SomaticVR/Eros-Hardware/3DModels/FXL6408UMX.stp

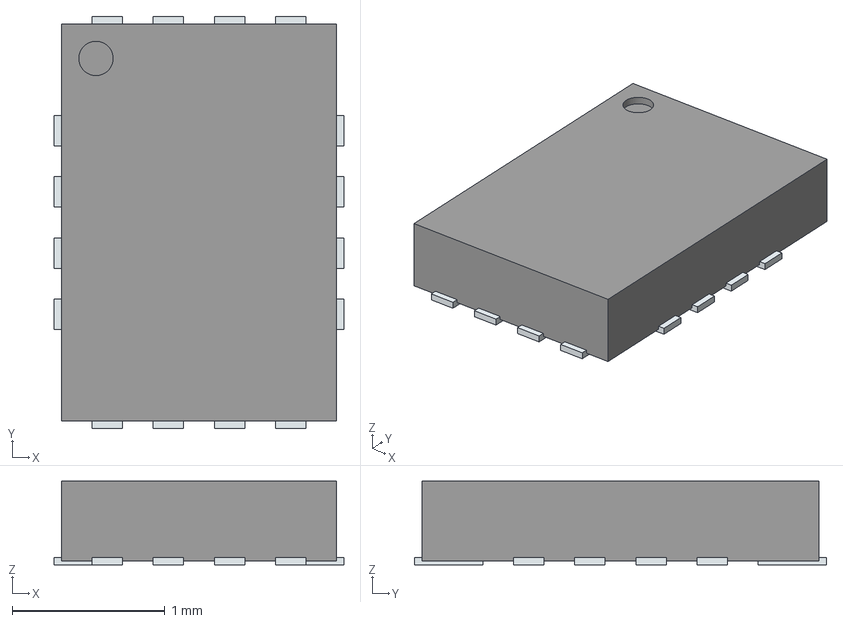
[picture p1: CAD file, 2025-02-08]
3DModels/FXL6408UMX.stp
1.90 x 2.70 x 0.55 mm
PinsArrayLR
PinsArrayTB
