SomaticVR/Eros-Hardware/3DModels/FUSB302BUCX.stp

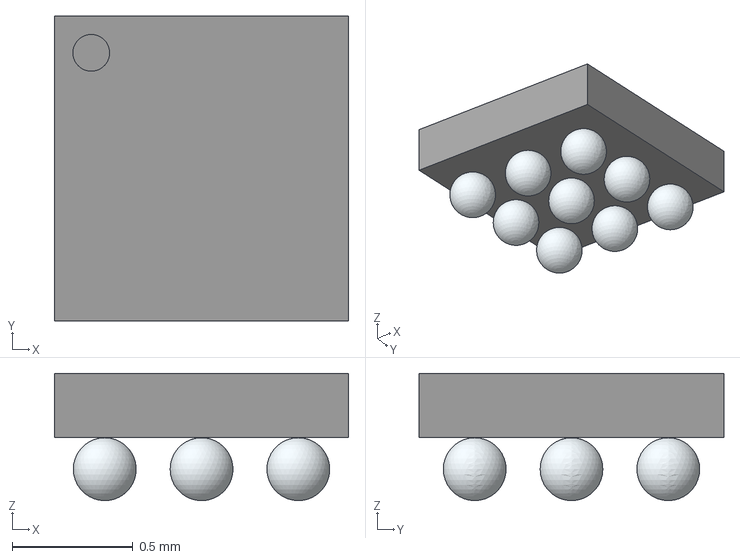
[picture p2: CAD file, 2025-02-08]
3DModels/FUSB302BUCX.stp
1.22 x 1.26 x 0.526 mm
