SomaticVR/Eros-Hardware/3DModels/CAY10-xxxJ4.stp

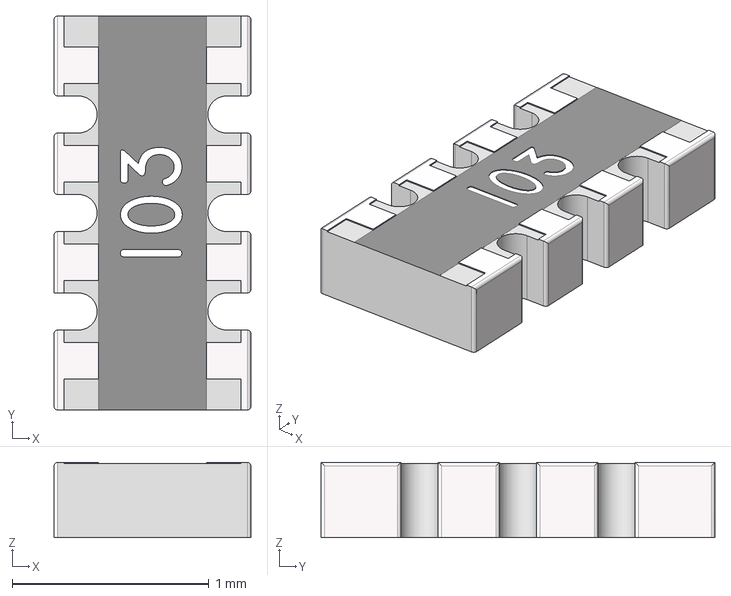
[picture p3: CAD file, 2023-10-31]
3DModels/CAY10-xxxJ4.stp
1.00 x 2.00 x 0.381 mm
