SomaticVR/Eros-Hardware/3DModels/USB4110-GF-A.stp

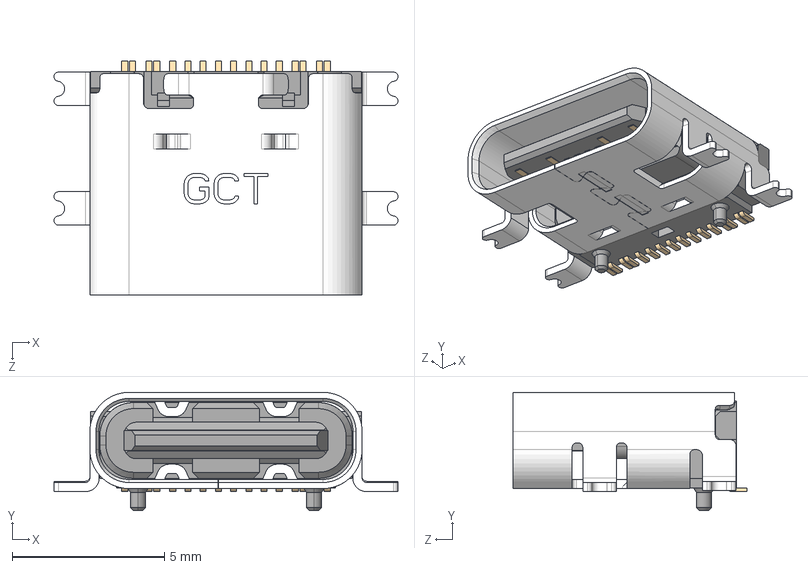
[picture p4: CAD file, 2023-10-31]
3DModels/USB4110-GF-A.stp
11.3 x 3.89 x 7.70 mm
