SomaticVR/Eros-Hardware/3DModels/EVQ-P7A01P.stp

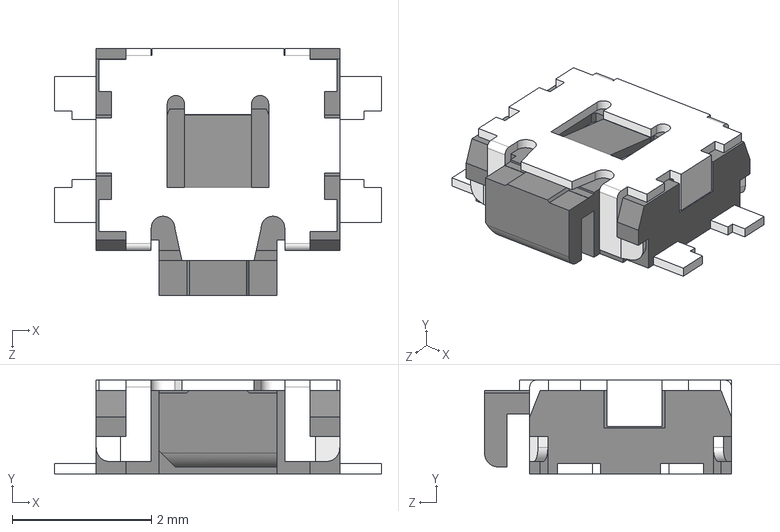
[picture p5: CAD file, 2023-10-31]
3DModels/EVQ-P7A01P.stp
4.70 x 1.35 x 3.55 mm
