SomaticVR/Eros-Hardware/3DModels/PESD5V2S2UT,215.stp

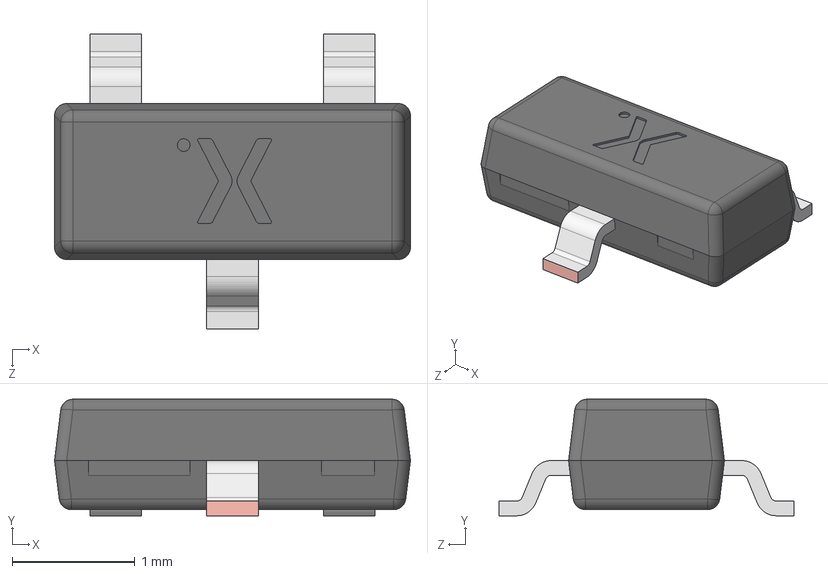
[picture p6: CAD file, 2023-10-31]
3DModels/PESD5V2S2UT,215.stp
2.90 x 0.95 x 2.40 mm
SOT23 lower body
SOT23 Lead x 3
SOT23 Upper body
