SomaticVR/Eros-Hardware/3DModels/S2B-PH-SM4-TB_LF__SN_ v2.step

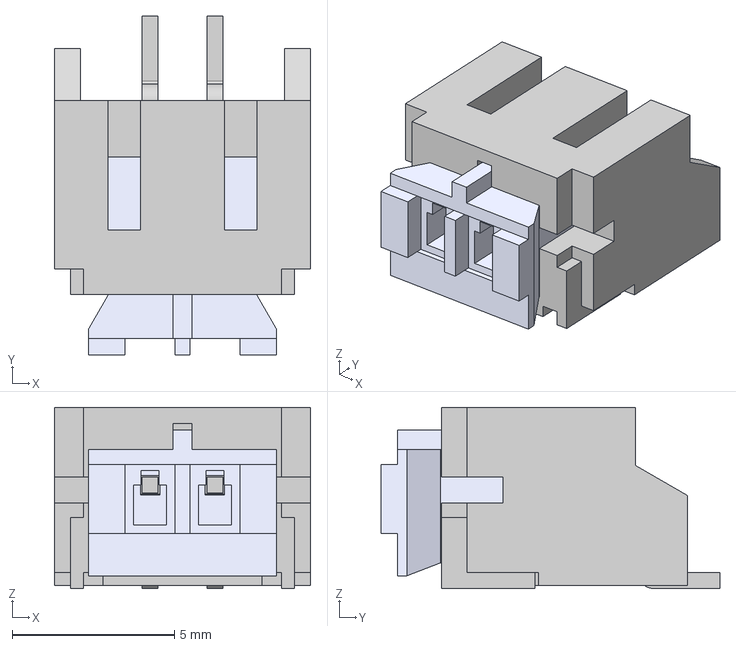
[picture p7: CAD file, 2023-10-31]
3DModels/S2B-PH-SM4-TB_LF__SN_ v2.step
7.90 x 10.5 x 5.60 mm
