SomaticVR/Eros-Hardware/3DModels/B2B-PH-SM4-TB_LF__SN_.stp

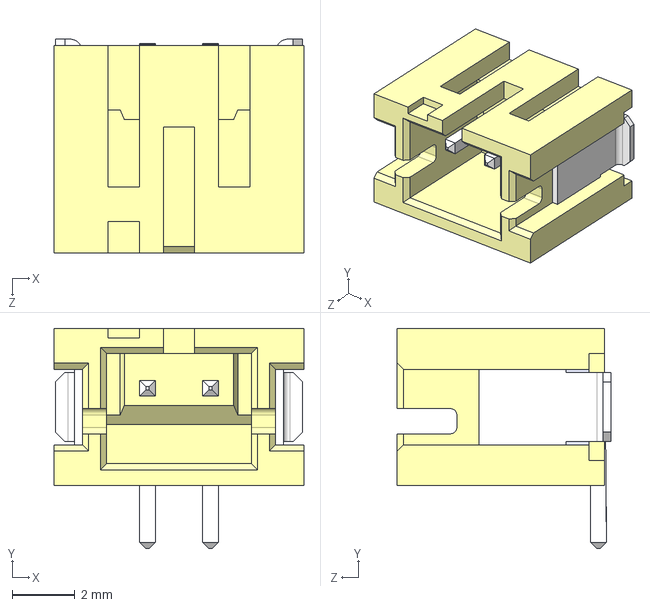
[picture p8: CAD file, 2023-10-31]
3DModels/B2B-PH-SM4-TB_LF__SN_.stp
7.95 x 7.00 x 6.80 mm
