SomaticVR/Eros-Hardware/3DModels/ESP32-C3-MINI-1-N4.step

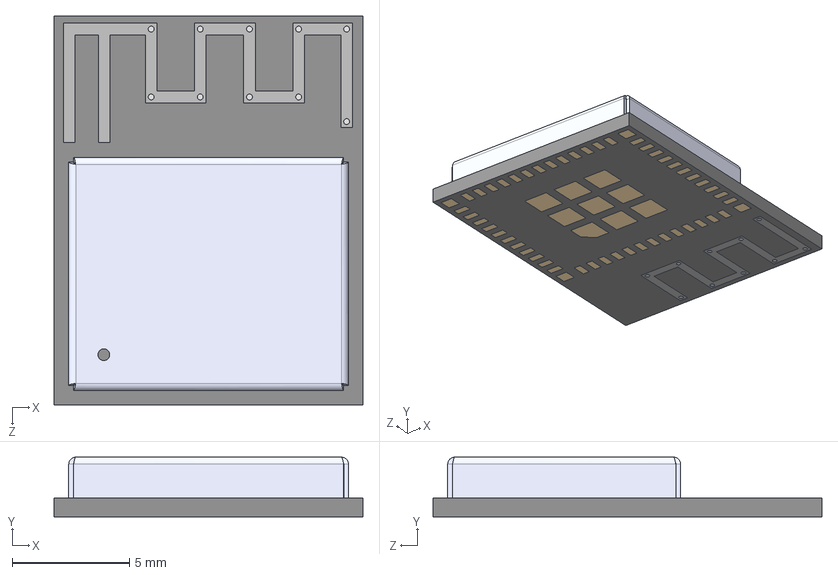
[picture p9: CAD file, 2023-10-31]
3DModels/ESP32-C3-MINI-1-N4.step
13.2 x 2.55 x 16.6 mm
