SomaticVR/Eros-Hardware/3DModels/4Z08V1345T7D2.stp

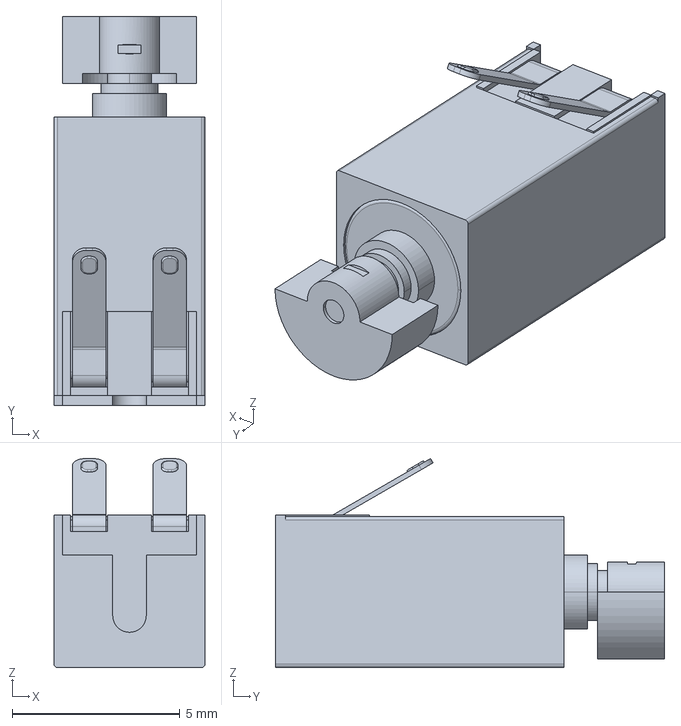
[picture p10: CAD file, 2023-10-31]
3DModels/4Z08V1345T7D2.stp
4.50 x 11.6 x 6.23 mm
