SomaticVR/Eros-Hardware/3DModels/ECMF02-4CMX8.stp

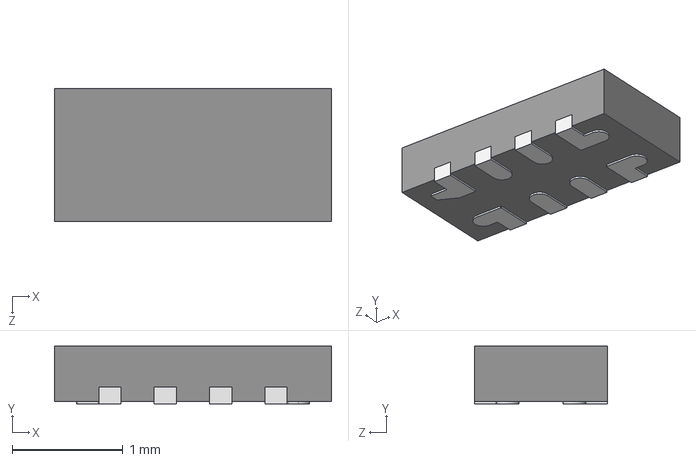
[picture p11: CAD file, 2023-10-31]
3DModels/ECMF02-4CMX8.stp
2.50 x 0.52 x 1.20 mm
