SomaticVR/Eros-Hardware/3DModels/Strike Plate v1.step

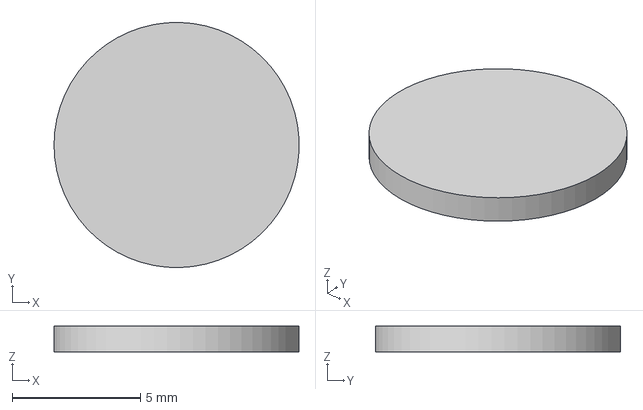
[picture p12: CAD file, 2023-06-08]
3DModels/Strike Plate v1.step
9.54 x 9.55 x 1.00 mm
