SomaticVR/Eros-Hardware/3DModels/BAS40VYX.stp

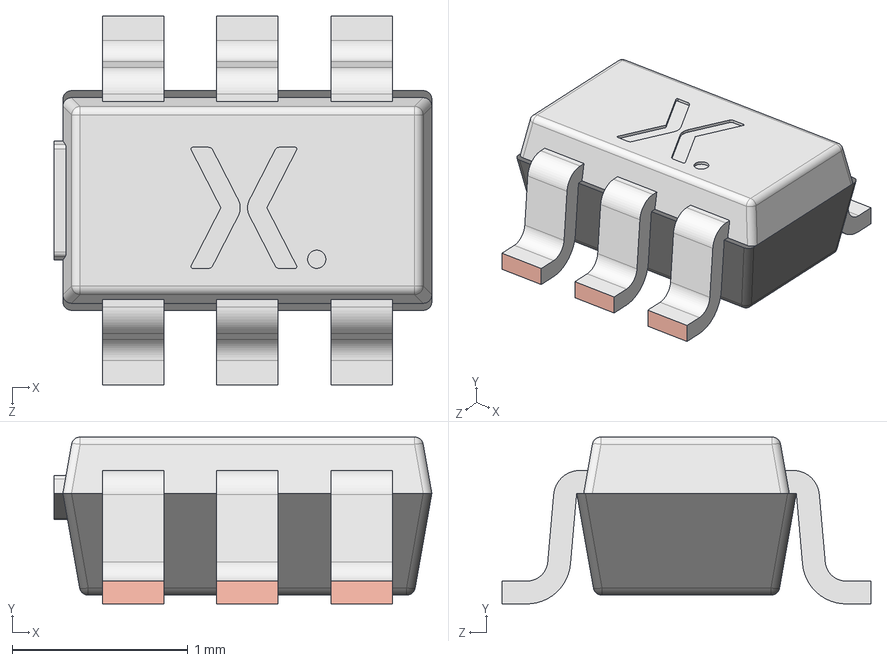
[picture p13: CAD file, 2023-06-04]
3DModels/BAS40VYX.stp
2.15 x 0.95 x 2.10 mm
SOT353 Lower body
SOT353 Lead x 6
SOT353 Upper body
