SomaticVR/Eros-Hardware/3DModels/keystone-PN24881.STEP

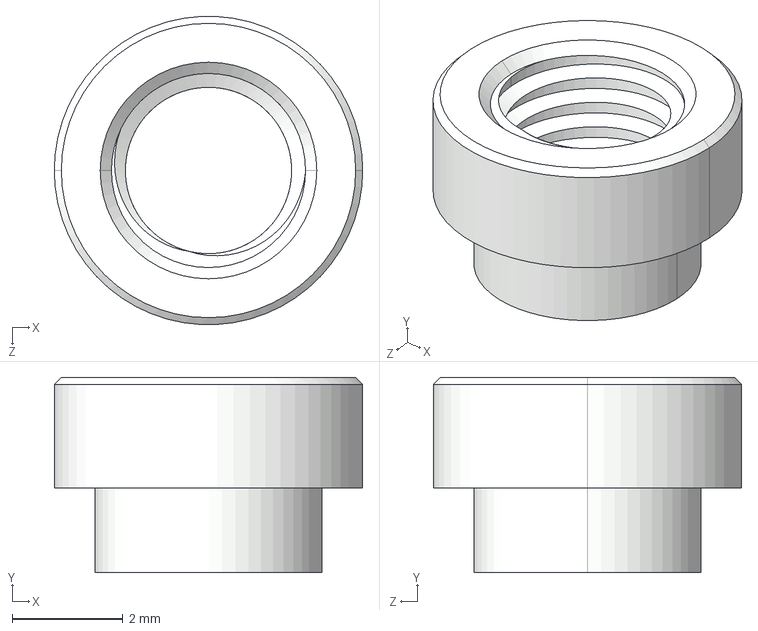
[picture p14: CAD file, 2023-06-04]
3DModels/keystone-PN24881.STEP
5.56 x 3.52 x 5.55 mm
