SomaticVR/Eros-Hardware/3DModels/JST - PH - SMD (R) - 2Pin - 2.00mm.stp

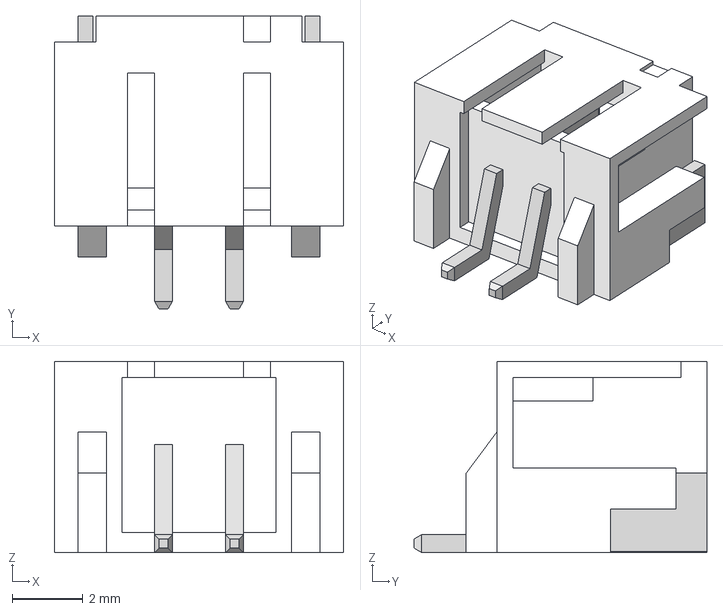
[picture p15: CAD file, 2023-06-04]
3DModels/JST - PH - SMD (R) - 2Pin - 2.00mm.stp
8.15 x 8.26 x 5.38 mm
