SomaticVR/Eros-Hardware/3DModels/SS34FA.stp

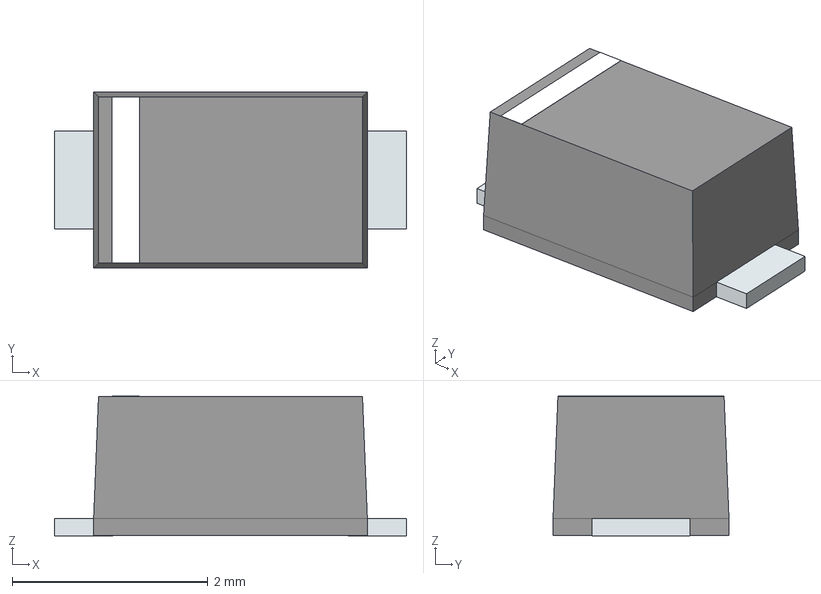
[picture p16: CAD file, 2023-06-04]
3DModels/SS34FA.stp
3.60 x 1.80 x 1.43 mm
PinKIdent
PinK
PinA
