SomaticVR/Eros-Hardware/3DModels/DMP2240UDM-7.stp

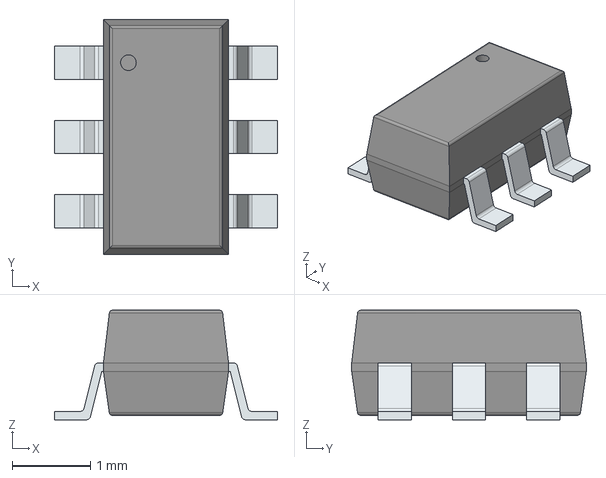
[picture p17: CAD file, 2023-06-04]
3DModels/DMP2240UDM-7.stp
2.85 x 3.00 x 1.40 mm
PinsArrayLR
