SomaticVR/Eros-Hardware/3DModels/APDA3020.STEP

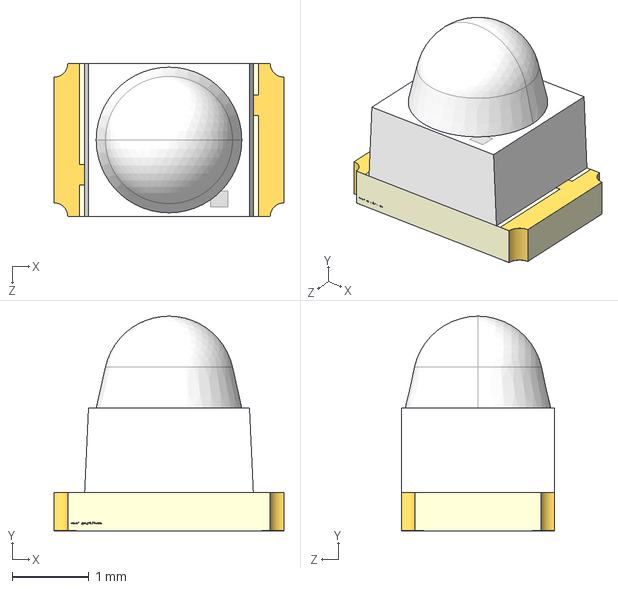
[picture p18: CAD file, 2023-06-04]
3DModels/APDA3020.STEP
3.00 x 2.80 x 2.00 mm
