SomaticVR/Eros-Hardware/3DModels/S2B-PH-SM4-TB_LF__SN_.stp

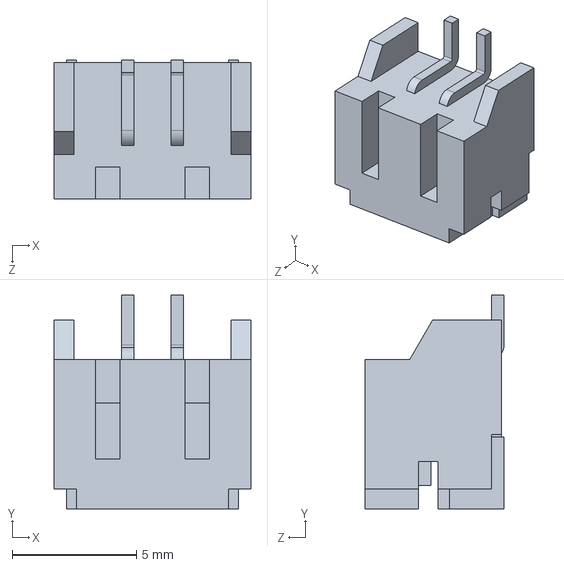
[picture p19: CAD file, 2023-06-04]
3DModels/S2B-PH-SM4-TB_LF__SN_.stp
7.90 x 8.60 x 5.60 mm
