SomaticVR/Eros-Hardware/3DModels/EVQ-9P701P.stp

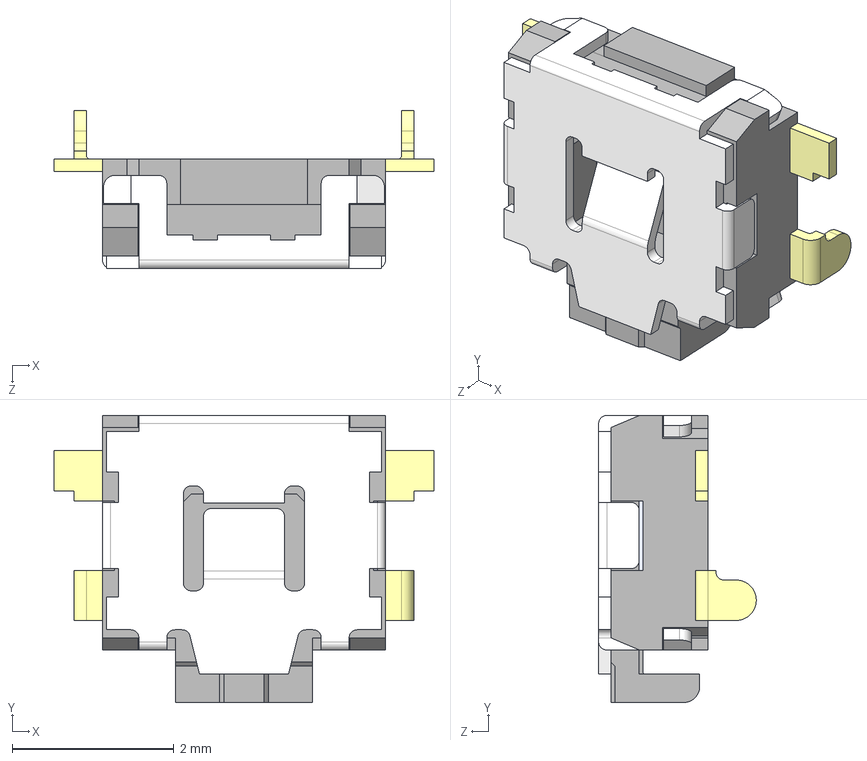
[picture p20: CAD file, 2023-06-04]
3DModels/EVQ-9P701P.stp
4.70 x 3.55 x 1.95 mm
