SomaticVR/Eros-Hardware/3DModels/JST - PH - SMD (R) - 8Pin - 2.00mm.stp

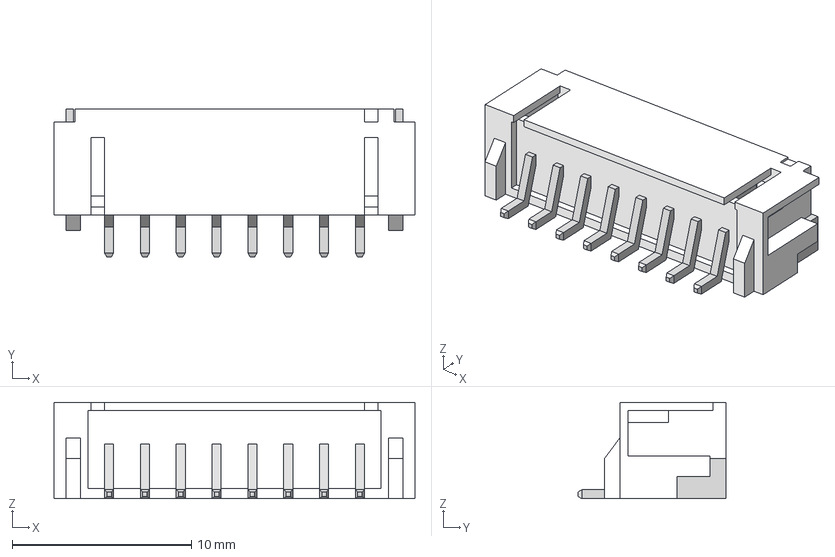
[picture p21: CAD file, 2023-06-04]
3DModels/JST - PH - SMD (R) - 8Pin - 2.00mm.stp
20.1 x 8.26 x 5.38 mm
