SomaticVR/Eros-Hardware/3DModels/ESP32-C3-WROOM-02-N4--3DModel-STEP-269445.STEP

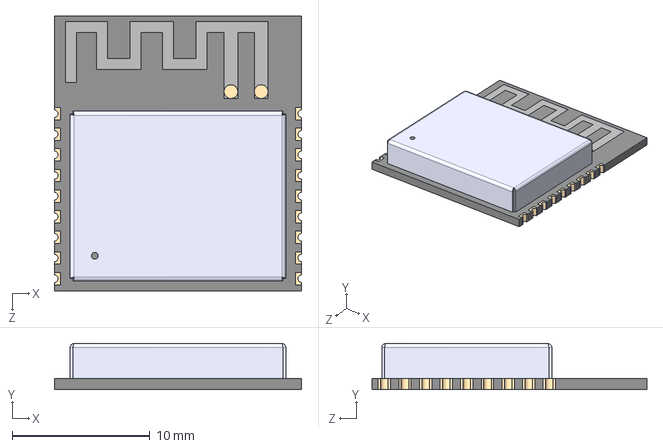
[picture p22: CAD file, 2023-04-05]
3DModels/ESP32-C3-WROOM-02-N4--3DModel-STEP-269445.STEP
18.0 x 3.35 x 20.0 mm
