SomaticVR/Eros-Hardware/(list of files, cad)

Other CAD files:
3DModels/S2B-PH-SM4-TB_LF__SN_ v1 with connector.step
3DModels/2171790001.stp
3DModels/AP62250Z6-7.stp
3DModels/BQ24074RGTRG4.stp
3DModels/BQ24196RGER.stp
3DModels/BQ25185DLHR.stp
3DModels/DFE252012F-1R0M=P2.stp
3DModels/DFE322512F-2R2M=P2.stp
3DModels/MCP73834-FCI_MF.stp
3DModels/TLV61070ADBVR.stp
3DModels/TPS563206DRLR.stp
