SomaticVR/Eros-Hardware/Eros Tracker.kicad_pcb

## KiCad design Eros Tracker.kicad_pcb (2025-02-08)

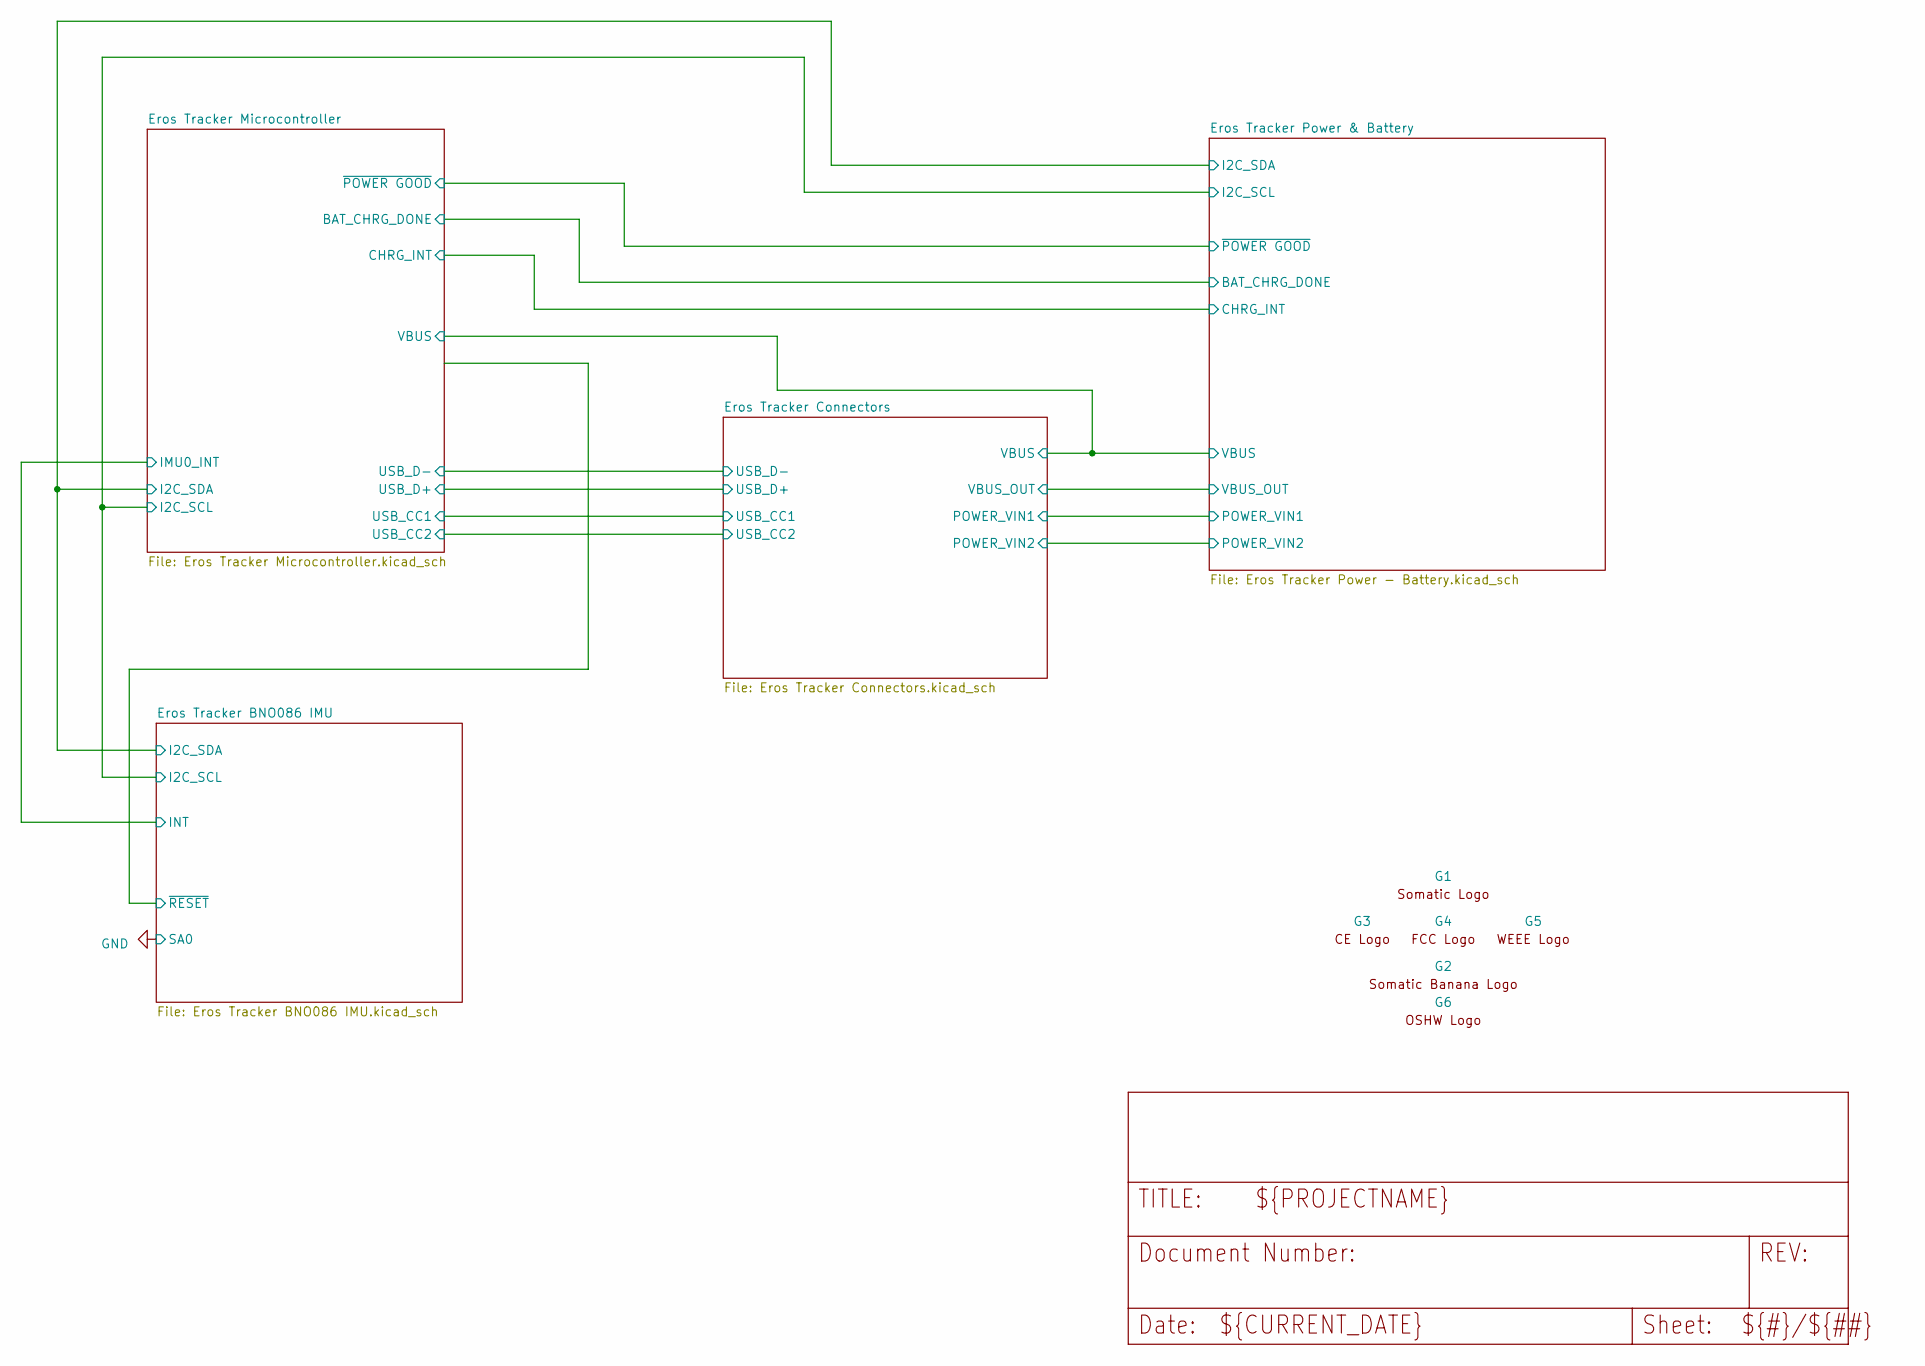
[picture p23: schematic Eros Tracker.kicad_sch]

Parts:
G1: SomaticLogo
G2: SomaticBananaLogo
G3: CE-Logo_7.0x5.0mm_SilkScreen
G4: FCC-Logo_6.2x5.0mm_SilkScreen
G5: WEEE-Logo_4.2x6mm_SilkScreen
G6: OSHW-Logo2_7.3x6mm_SilkScreen

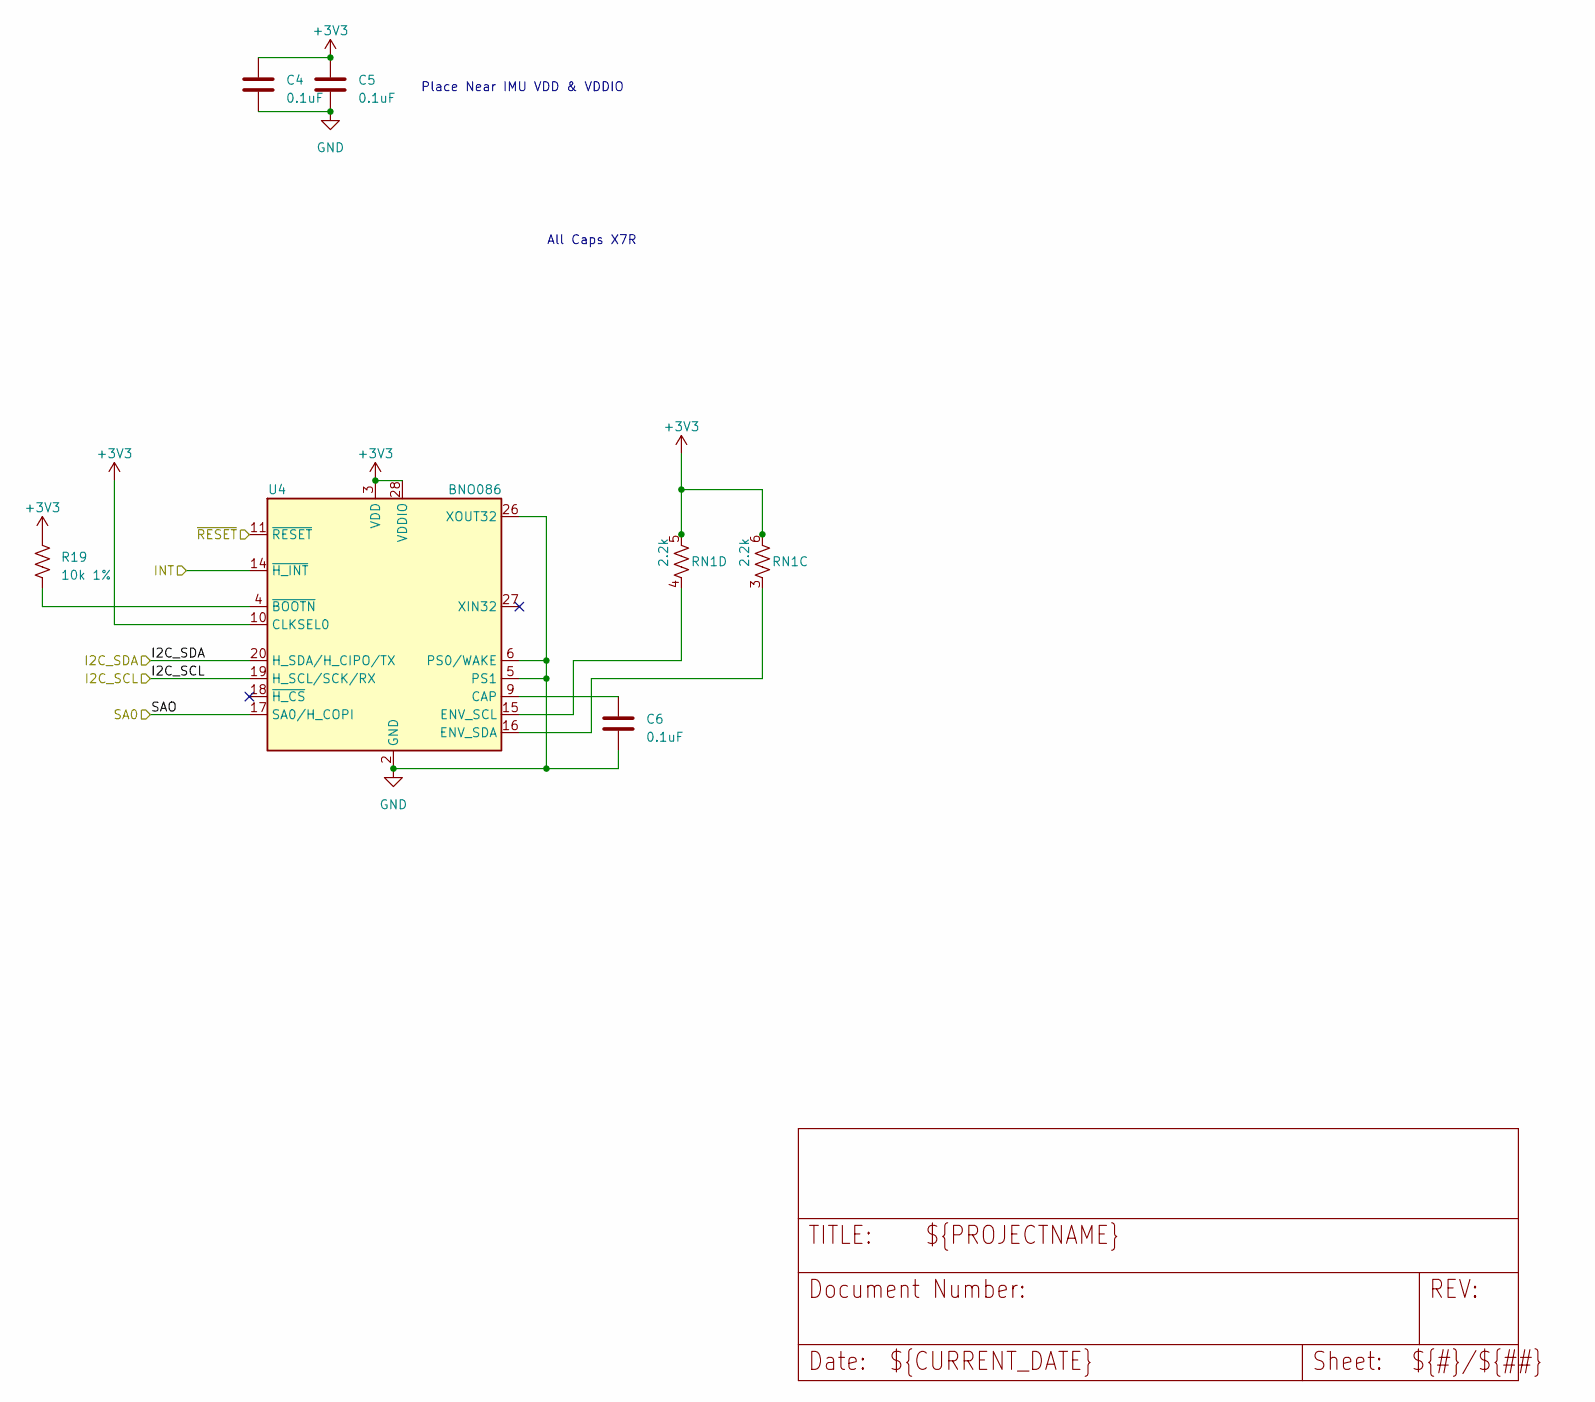
[picture p24: schematic Eros Tracker BNO086 IMU.kicad_sch]

Parts:
C4, C5, C6: 0.1uF; C_0402_1005Metric; Manufacturer_Part_Number CL05B104KA5NNNC; Mouser Part Number 187-CL05B104KA5NNNC
R19: 10k 1%; R_0402_1005Metric; Manufacturer_Part_Number RT0402FRE0710KL; Mouser Part Number 603-RT0402FRE0710KL
RN1: 2.2k; CAY10-xxxJ4; Manufacturer_Part_Number CAY10-222J4LF; Mouser Part Number 652-CAY10-222J4LF
U4: BNO086; LGA-28_5.2x3.8mm_P0.5mm; Manufacturer_Part_Number BNO086; DigiKey Part Number 1888-BNO086CT-ND

Connections:
+3V3: C4.1, C5.1, R19.1, RN1.5, RN1.6, U4.3 (VDD), U4.10 (CLKSEL0), U4.28 (VDDIO); also elsewhere on the board
/Eros Tracker BNO086 IMU/I2C_SCL: U4.19 (H_SCL/SCK/RX); also elsewhere on the board
/Eros Tracker BNO086 IMU/I2C_SDA: U4.20 (H_SDA/H_CIPO/TX); also elsewhere on the board
/Eros Tracker BNO086 IMU/INT: U4.14 (~H_INT); also elsewhere on the board
/Eros Tracker BNO086 IMU/~RESET: U4.11 (~RESET)
GND: C4.2, C5.2, C6.2, U4.2 (GND), U4.5 (PS1), U4.6 (PS0/WAKE), U4.17 (SA0/H_COPI), U4.25 (GNDIO), U4.26 (XOUT32); also elsewhere on the board
unnamed: C6.1, U4.9 (CAP)
unnamed: RN1.4, U4.15 (ENV_SCL)
unnamed: RN1.3, U4.16 (ENV_SDA)
unnamed: R19.2, U4.4 (~BOOTN)

Notes on the sheet:
Place Near IMU VDD & VDDIO
All Caps X7R

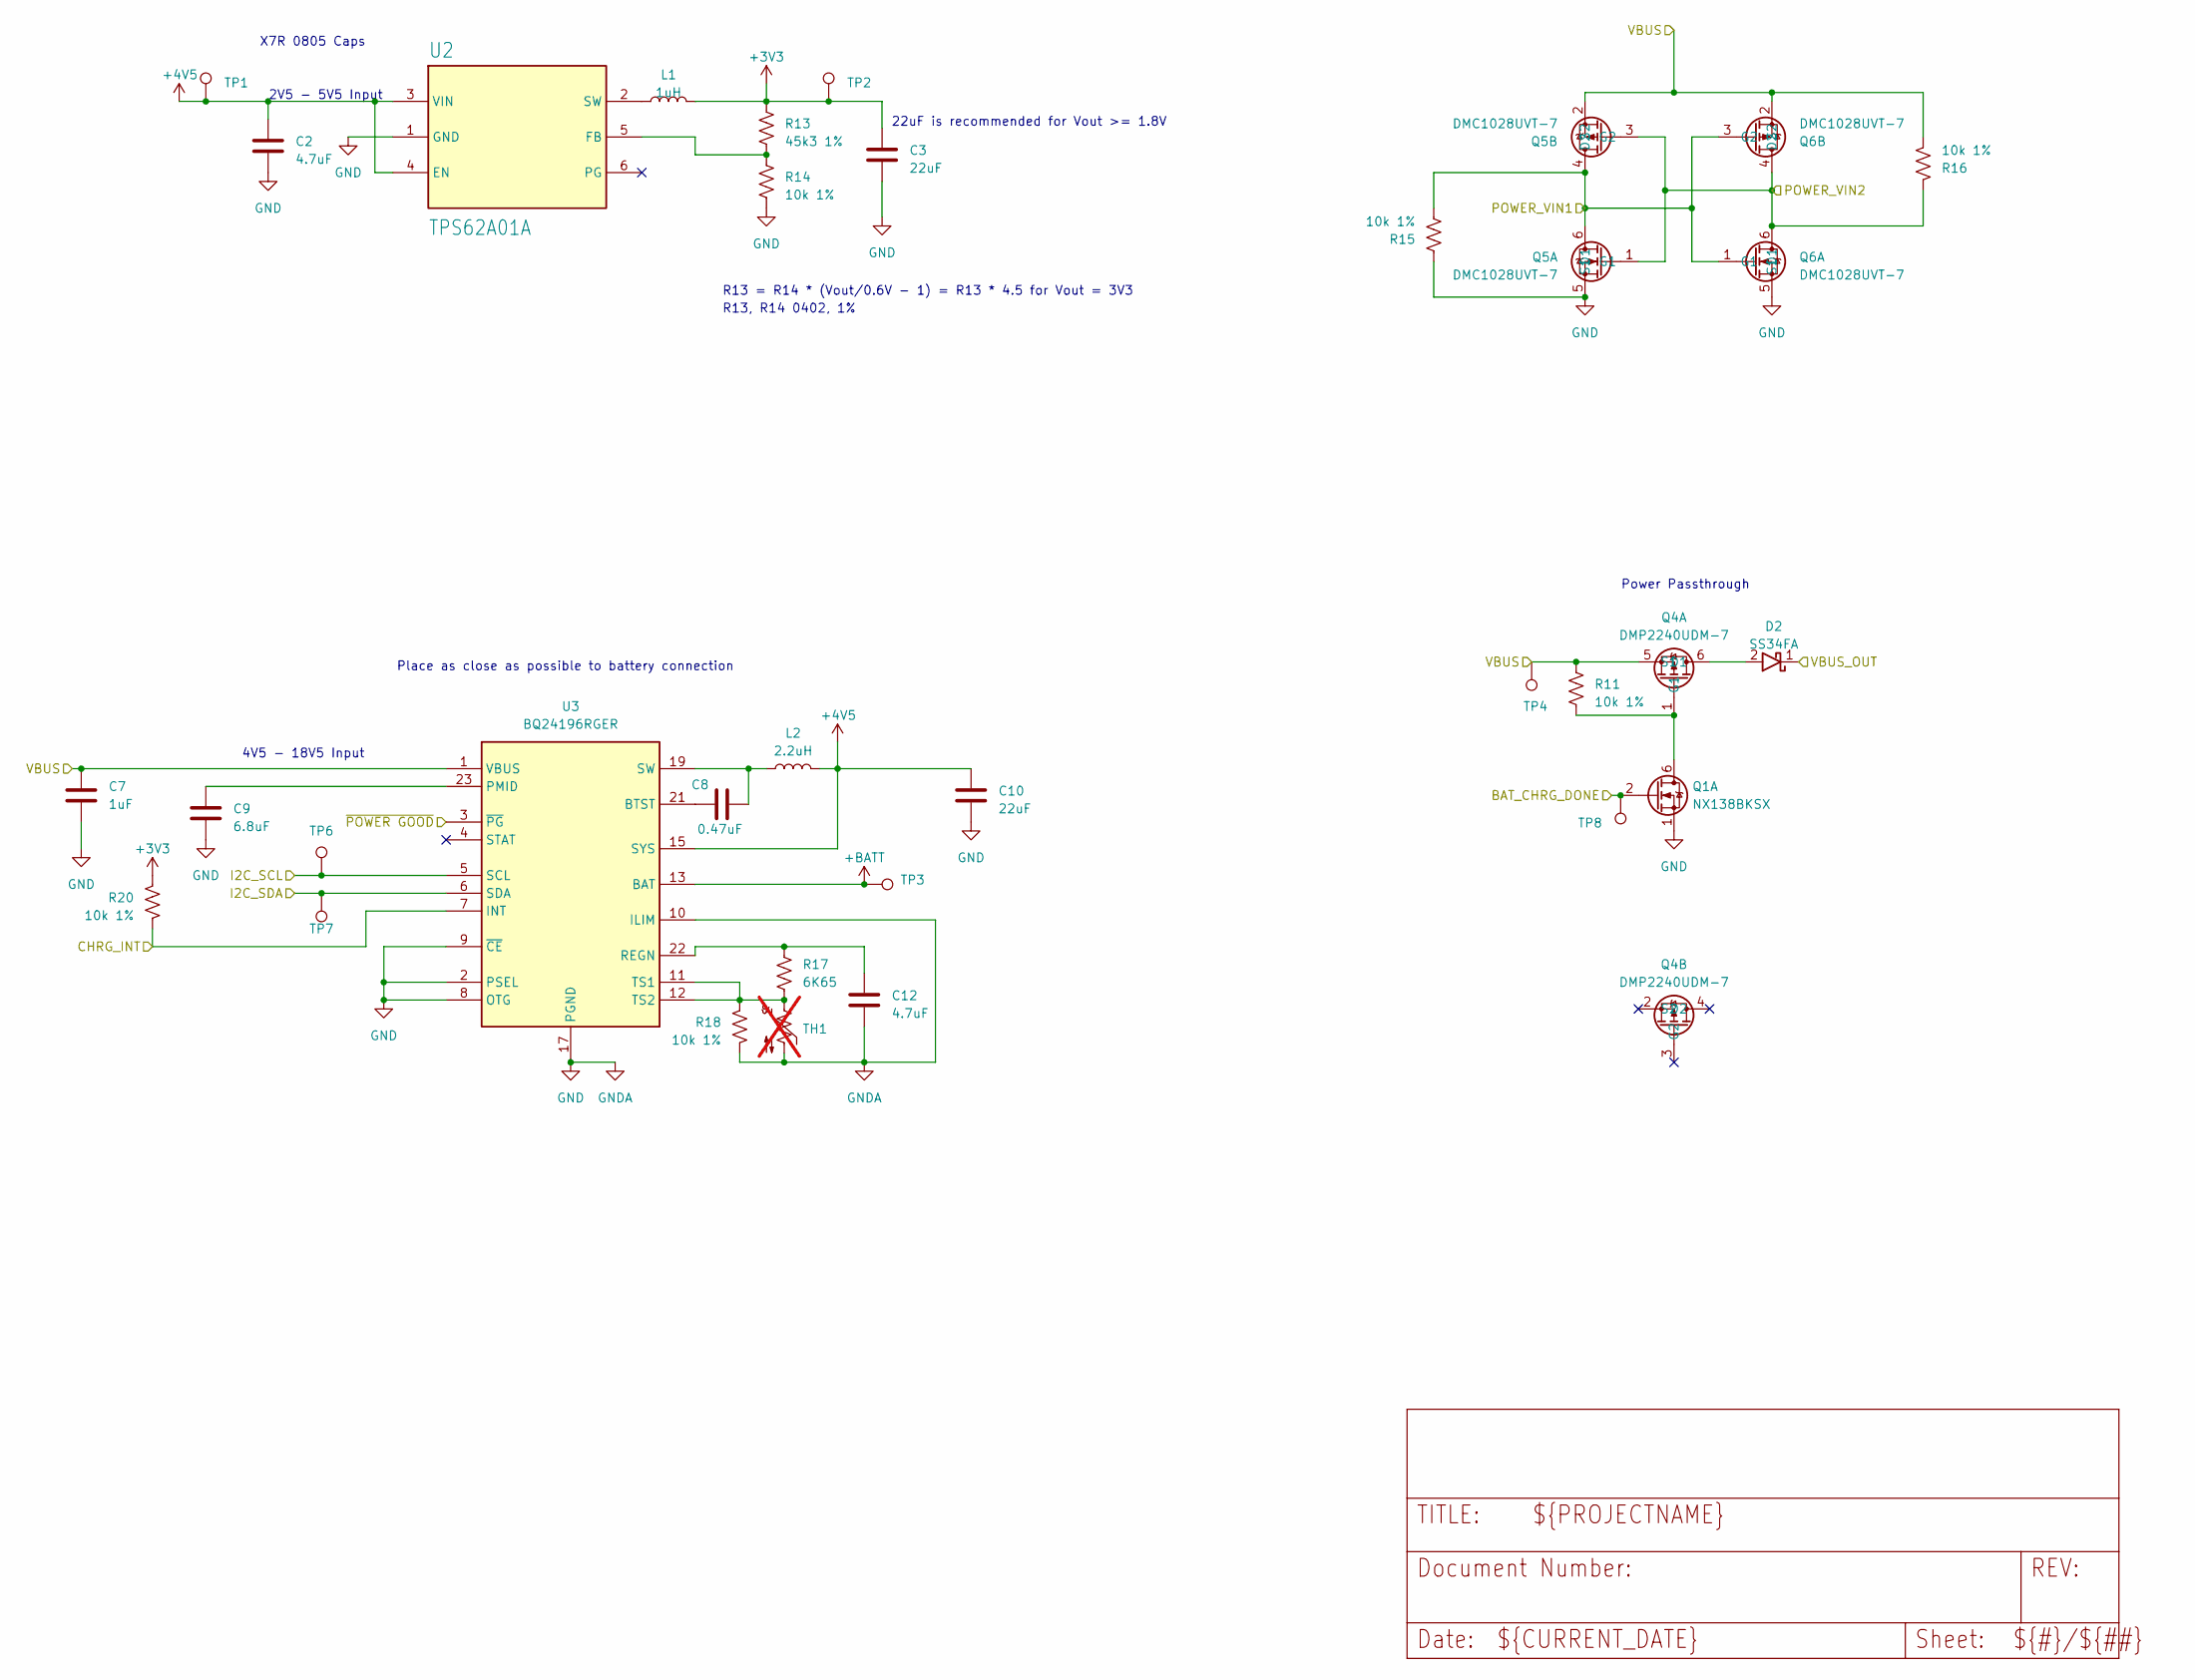
[picture p25: schematic Eros Tracker Power - Battery.kicad_sch]

Parts:
C2, C12: 4.7uF; C_0603_1608Metric; Manufacturer_Part_Number GRM188Z71C475KE21D; Mouser Part Number 81-GRM188Z71C475KE1D
C3, C10: 22uF; C_0805_2012Metric; Manufacturer_Part_Number GRM21BZ71A226ME15L; Mouser Part Number 81-GRM21BZ71A226ME5L
C7: 1uF; C_0603_1608Metric; Manufacturer_Part_Number MLASU168AB7105KTNA01; Mouser Part Number 963-MLASU168AB7105KT
C8: 0.47uF; C_0402_1005Metric; Manufacturer_Part_Number CC0402KRX7R6BB474; Mouser Part Number 603-CC0402KR6BB474
C9: 6.8uF; C_1210_3225Metric; Manufacturer_Part_Number C3225X7R1E685K250AB; Mouser Part Number 810-C3225X7R1E685K11
D2: SS34FA; SODFL3618X143N; Mouser Part Number 512-SS34FA
L1: 1uH; DFE2HCAH1R0MJ0L; Manufacturer_Part_Number DFE252012F-1R0M=P2; Mouser Part Number 81-DFE252012F-1R0MP2
L2: 2.2uH; 1277ASH100MP2; Manufacturer_Part_Number DFE322512F-2R2M=P2; Mouser Part Number 81-DFE322512F-2R2MP2
Q1: NX138BKSX; SOT65P210X110-6N; Mouser Part Number 771-NX138BKSX
Q4: DMP2240UDM-7; SOT95P285X140-6N; Mouser Part Number 621-DMP2240UDM-7
Q5, Q6: DMC1028UVT-7; SOT95P285X140-6N; Mouser Part Number 621-DMC1028UVT-7
R11, R14, R15, R16, R18, R20: 10k 1%; R_0402_1005Metric; Manufacturer_Part_Number RT0402FRE0710KL; Mouser Part Number 603-RT0402FRE0710KL
R13: 45k3 1%; R_0402_1005Metric; Manufacturer_Part_Number RR0510P-4532-D; Mouser Part Number 754-RR0510P-4532D
R17: 6K65; R_0402_1005Metric; Manufacturer_Part_Number RT0402DRE076K65L; Mouser Part Number 603-RT0402DRE076K65L
TH1: 10k; R_0402_1005Metric; Manufacturer_Part_Number NTCG103UH103HT1; Mouser Part Number 810-NTCG103UH103HT1; not fitted
TP1, TP2, TP3, TP4, TP6, TP7, TP8: TestPoint; TestPoint_Pad_D1.0mm
U2: TPS62A01A; TPS62A0xA-SOT-563; Manufacturer_Part_Number TPS62A01ADRLR; Mouser Part Number 595-TPS62A01ADRLR
U3: BQ24196RGER; QFN50P400X400X100-25N-D; Mouser Part Number 595-BQ24196RGER

Connections:
+3V3: C3.1, L1.2, R13.1, R20.1, TP2.1; also elsewhere on the board
+4V5: C2.1, C10.1, L2.2, TP1.1, U2.3 (VIN), U2.4 (EN), U3.15 (SYS), U3.16 (SYS_2); also elsewhere on the board
+BATT: TP3.1, U3.13 (BAT), U3.14 (BAT_2); also elsewhere on the board
/Eros Tracker BNO086 IMU/I2C_SCL: TP6.1, U3.5 (SCL); also elsewhere on the board
/Eros Tracker BNO086 IMU/I2C_SDA: TP7.1, U3.6 (SDA); also elsewhere on the board
/Eros Tracker Connectors/POWER_VIN1: Q5.4 (D2), Q5.6 (D1), Q6.1 (G1), Q6.3 (G2), R15.2; also elsewhere on the board
/Eros Tracker Connectors/POWER_VIN2: Q5.1 (G1), Q5.3 (G2), Q6.4 (D2), Q6.6 (D1), R16.1; also elsewhere on the board
/Eros Tracker Connectors/VBUS: C7.1, Q4.5 (S1), Q5.2 (S2), Q6.2 (S2), R11.1, R16.2, TP4.1, U3.1 (VBUS), U3.24 (VBUS_2); also elsewhere on the board
/Eros Tracker Connectors/VBUS_OUT: D2.1 (K); also elsewhere on the board
/Eros Tracker Microcontroller/BAT_CHRG_DONE: Q1.2 (G1), TP8.1; also elsewhere on the board
/Eros Tracker Microcontroller/CHRG_INT: R20.2, U3.7 (INT); also elsewhere on the board
/Eros Tracker Microcontroller/~POWER GOOD: U3.3 (~PG); also elsewhere on the board
GND: C2.2, C3.2, C7.2, C9.2, C10.2, C12.2, Q1.1 (S1), Q5.5 (S1), Q6.5 (S1), R14.2, R15.1, R18.2, TH1.2, U2.1 (GND), U3.2 (PSEL), U3.8 (OTG), U3.9 (~CE), U3.10 (ILIM), U3.17 (PGND), U3.18 (PGND_2), U3.25 (EP); also elsewhere on the board
unnamed: D2.2 (A), Q4.6 (D1)
unnamed: Q1.6 (D1), Q4.1 (G1), R11.2
unnamed: R13.2, R14.1, U2.5 (FB)
unnamed: L1.1, U2.2 (SW)
unnamed: C8.1, U3.21 (BTST)
unnamed: C9.1, U3.23 (PMID)
unnamed: C12.1, R17.1, U3.22 (REGN)
unnamed: C8.2, L2.1, U3.19 (SW), U3.20 (SW_2)
unnamed: R17.2, R18.1, TH1.1, U3.11 (TS1), U3.12 (TS2)

Notes on the sheet:
22uF is recommended for Vout >= 1.8V
R13 = R14 * (Vout/0.6V - 1) = R13 * 4.5 for Vout = 3V3
Power Passthrough
2V5 - 5V5 Input
4V5 - 18V5 Input
X7R 0805 Caps
Place as close as possible to battery connection
R13, R14 0402, 1%

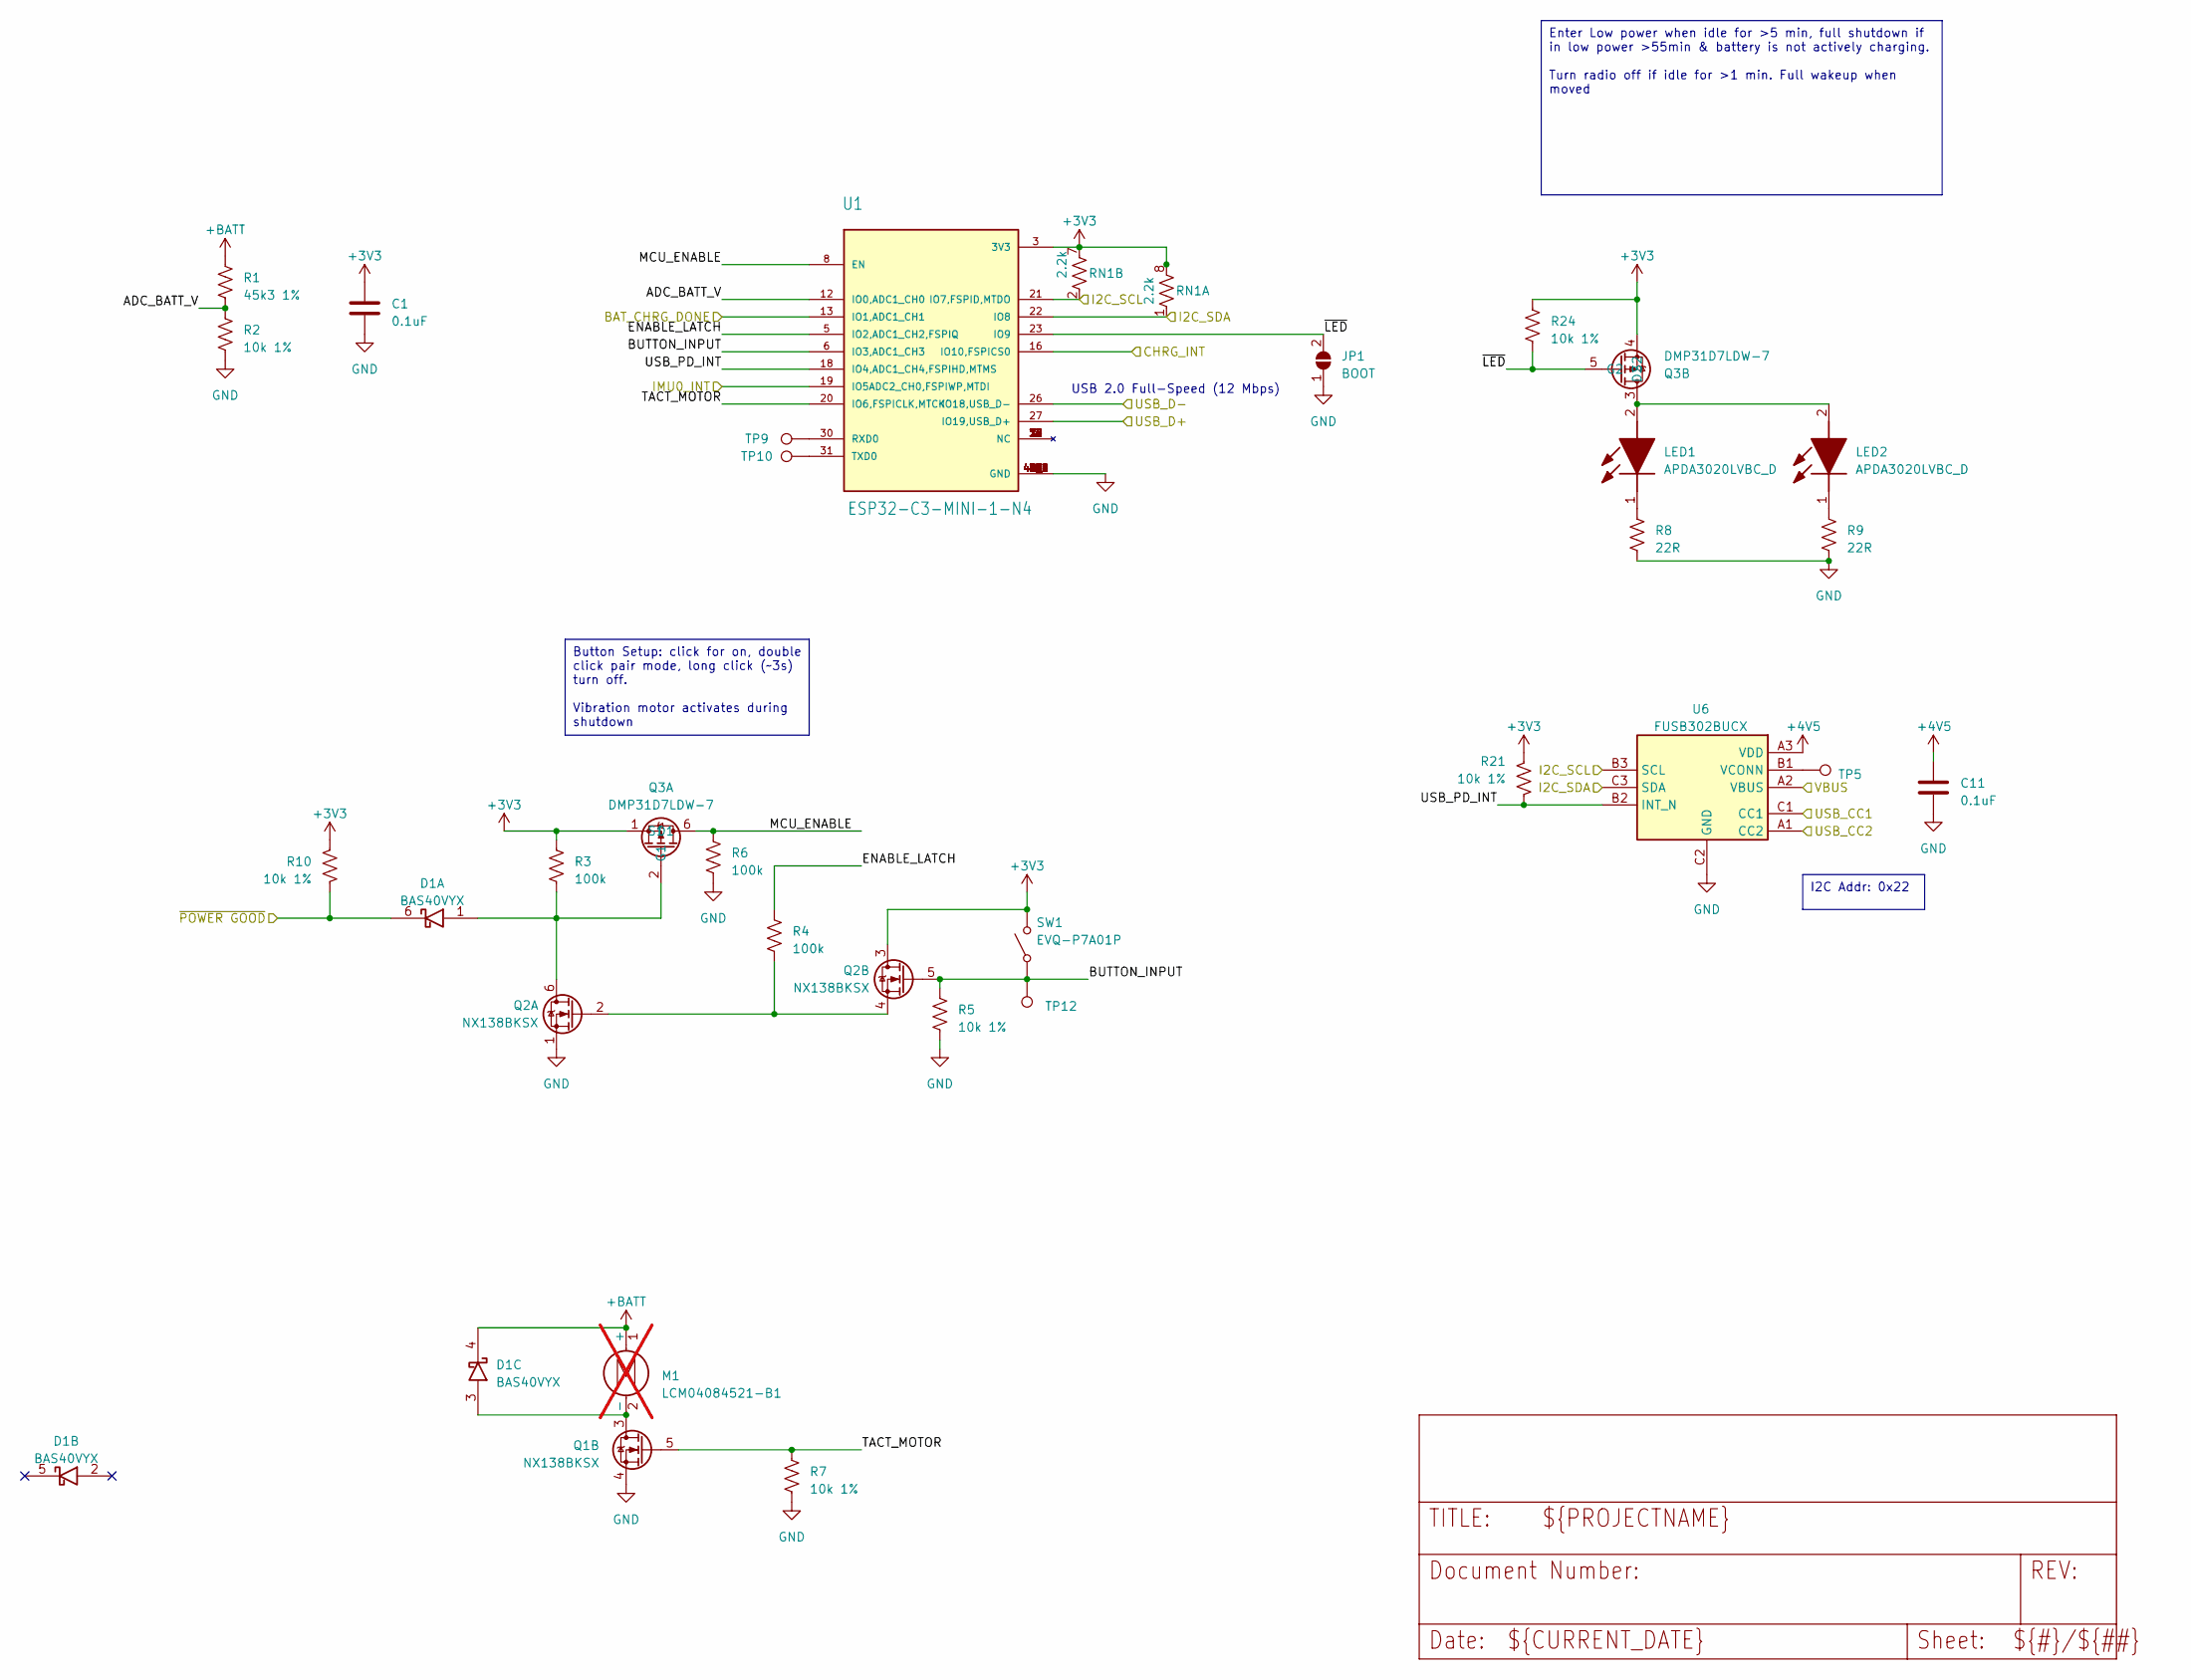
[picture p26: schematic Eros Tracker Microcontroller.kicad_sch]

Parts:
C1, C11: 0.1uF; C_0402_1005Metric; Manufacturer_Part_Number CL05B104KA5NNNC; Mouser Part Number 187-CL05B104KA5NNNC
D1: BAS40VYX; SOT65P210X110-6N; Manufacturer_Part_Number BAS40VYX
JP1: BOOT; SolderJumper-2_P1.3mm_Open_RoundedPad1.0x1.5mm
LED1, LED2: APDA3020LVBC_D; APDA3020LVBCD; Mouser Part Number 604-APDA3020LVBCD
M1: LCM04084521-B1; not fitted
Q1, Q2: NX138BKSX; SOT65P210X110-6N; Mouser Part Number 771-NX138BKSX
Q3: DMP31D7LDW-7; SOT65P210X110-6N; Mouser Part Number 621-DMP31D7LDW-7
R1: 45k3 1%; R_0402_1005Metric; Manufacturer_Part_Number RR0510P-4532-D; Mouser Part Number 754-RR0510P-4532D
R2, R5, R7, R10, R21, R24: 10k 1%; R_0402_1005Metric; Manufacturer_Part_Number RT0402FRE0710KL; Mouser Part Number 603-RT0402FRE0710KL
R3, R4, R6: 100k; R_0402_1005Metric; Manufacturer_Part_Number RT0402FRE07100KL; Mouser Part Number 603-RT0402FRE07100KL
R8, R9: 22R; R_0402_1005Metric; Manufacturer_Part_Number RT0402FRE0722RL; Mouser Part Number 603-RT0402FRE0722RL
RN1: 2.2k; CAY10-xxxJ4; Manufacturer_Part_Number CAY10-222J4LF; Mouser Part Number 652-CAY10-222J4LF
SW1: EVQ-P7A01P; EVQ-P7J01P; Mouser Part Number 667-EVQP7A01P
TP5, TP9, TP10, TP12: TestPoint; TestPoint_Pad_D1.0mm
U1: ESP32-C3-MINI-1-N4; XCVR_ESP32-C3-MINI-1-N4; Manufacturer_Part_Number ESP32-C3-MINI-1-N4; Mouser Part Number 356-ESP32-C3-MINI1N4
U6: FUSB302BUCX; BGA9C40P3X3_122X126X53; Mouser Part Number 512-FUSB302BUCX

Connections:
+3V3: C1.1, Q2.3 (D2), Q3.1 (S1), Q3.4 (S2), R3.1, R10.1, R21.1, R24.1, RN1.7, RN1.8, SW1.3 (COM_2), SW1.4 (COM_1), U1.3 (3V3); also elsewhere on the board
+4V5: C11.1, U6.A3 (VDD); also elsewhere on the board
+BATT: D1.4 (K3), M1.1 (+), R1.1; also elsewhere on the board
/Eros Tracker BNO086 IMU/I2C_SCL: RN1.2, U1.21 (IO7,FSPID,MTDO), U6.B3 (SCL); also elsewhere on the board
/Eros Tracker BNO086 IMU/I2C_SDA: RN1.1, U1.22 (IO8), U6.C3 (SDA); also elsewhere on the board
/Eros Tracker BNO086 IMU/INT: U1.19 (IO5ADC2_CH0,FSPIWP,MTDI); also elsewhere on the board
/Eros Tracker Connectors/USB_CC1: U6.C1 (CC1); also elsewhere on the board
/Eros Tracker Connectors/USB_CC2: U6.A1 (CC2); also elsewhere on the board
/Eros Tracker Connectors/USB_D+: U1.27 (IO19,USB_D+); also elsewhere on the board
/Eros Tracker Connectors/USB_D-: U1.26 (IO18,USB_D-); also elsewhere on the board
/Eros Tracker Connectors/VBUS: U6.A2 (VBUS); also elsewhere on the board
/Eros Tracker Microcontroller/ADC_BATT_V: R1.2, R2.1, U1.12 (IO0,ADC1_CH0)
/Eros Tracker Microcontroller/BAT_CHRG_DONE: U1.13 (IO1,ADC1_CH1); also elsewhere on the board
/Eros Tracker Microcontroller/BUTTON_INPUT: Q2.5 (G2), R5.1, SW1.1 (NO_1), SW1.2 (NO_2), TP12.1, U1.6 (IO3,ADC1_CH3)
/Eros Tracker Microcontroller/CHRG_INT: U1.16 (IO10,FSPICS0); also elsewhere on the board
/Eros Tracker Microcontroller/ENABLE_LATCH: R4.1, U1.5 (IO2,ADC1_CH2,FSPIQ)
/Eros Tracker Microcontroller/MCU_ENABLE: Q3.6 (D1), R6.1, U1.8 (EN)
/Eros Tracker Microcontroller/TACT_MOTOR: Q1.5 (G2), R7.1, U1.20 (IO6,FSPICLK,MTCK)
/Eros Tracker Microcontroller/USB_PD_INT: R21.2, U1.18 (IO4,ADC1_CH4,FSPIHD,MTMS), U6.B2 (INT_N)
/Eros Tracker Microcontroller/~LED: JP1.2 (B), Q3.5 (G2), R24.2, U1.23 (IO9)
/Eros Tracker Microcontroller/~POWER GOOD: D1.6 (K1), R10.2; also elsewhere on the board
GND: C1.2, C11.2, JP1.1 (A), Q1.4 (S2), Q2.1 (S1), R2.2, R5.2, R6.2, R7.2, R8.2, R9.2, U1.1 (GND), U1.2 (GND), U1.11 (GND), U1.14 (GND), U1.36 (GND), U1.37 (GND), U1.38 (GND), U1.39 (GND), U1.40 (GND), U1.41 (GND), U1.42 (GND), U1.43 (GND), U1.44 (GND), U1.45 (GND), U1.46 (GND), U1.47 (GND), U1.48 (GND), U1.49_1 (GND), U1.49_2 (GND), U1.49_3 (GND), U1.49_4 (GND), U1.49_5 (GND), U1.49_6 (GND), U1.49_7 (GND), U1.49_8 (GND), U1.49_9 (GND), U1.50 (GND), U1.51 (GND), U1.52 (GND), U1.53 (GND), U6.C2 (GND); also elsewhere on the board
unnamed: D1.1 (A1), Q2.6 (D1), Q3.2 (G1), R3.2
unnamed: D1.3 (A3), M1.2 (-), Q1.3 (D2)
unnamed: LED1.2 (A), LED2.2 (A), Q3.3 (D2)
unnamed: LED1.1 (K), R8.1
unnamed: LED2.1 (K), R9.1
unnamed: Q2.2 (G1), Q2.4 (S2), R4.2
unnamed: TP9.1, U1.30 (RXD0)
unnamed: TP10.1, U1.31 (TXD0)
unnamed: TP5.1, U6.B1 (VCONN)

Notes on the sheet:
Button Setup: click for on, double click pair mode, long click (~3s) turn off. Vibration motor activates during shutdown
Enter Low power when idle for >5 min, full shutdown if in low power >55min & battery is not actively charging. Turn radio off if idle for >1 min. Full wakeup when moved
I2C Addr: 0x22
USB 2.0 Full-Speed (12 Mbps)

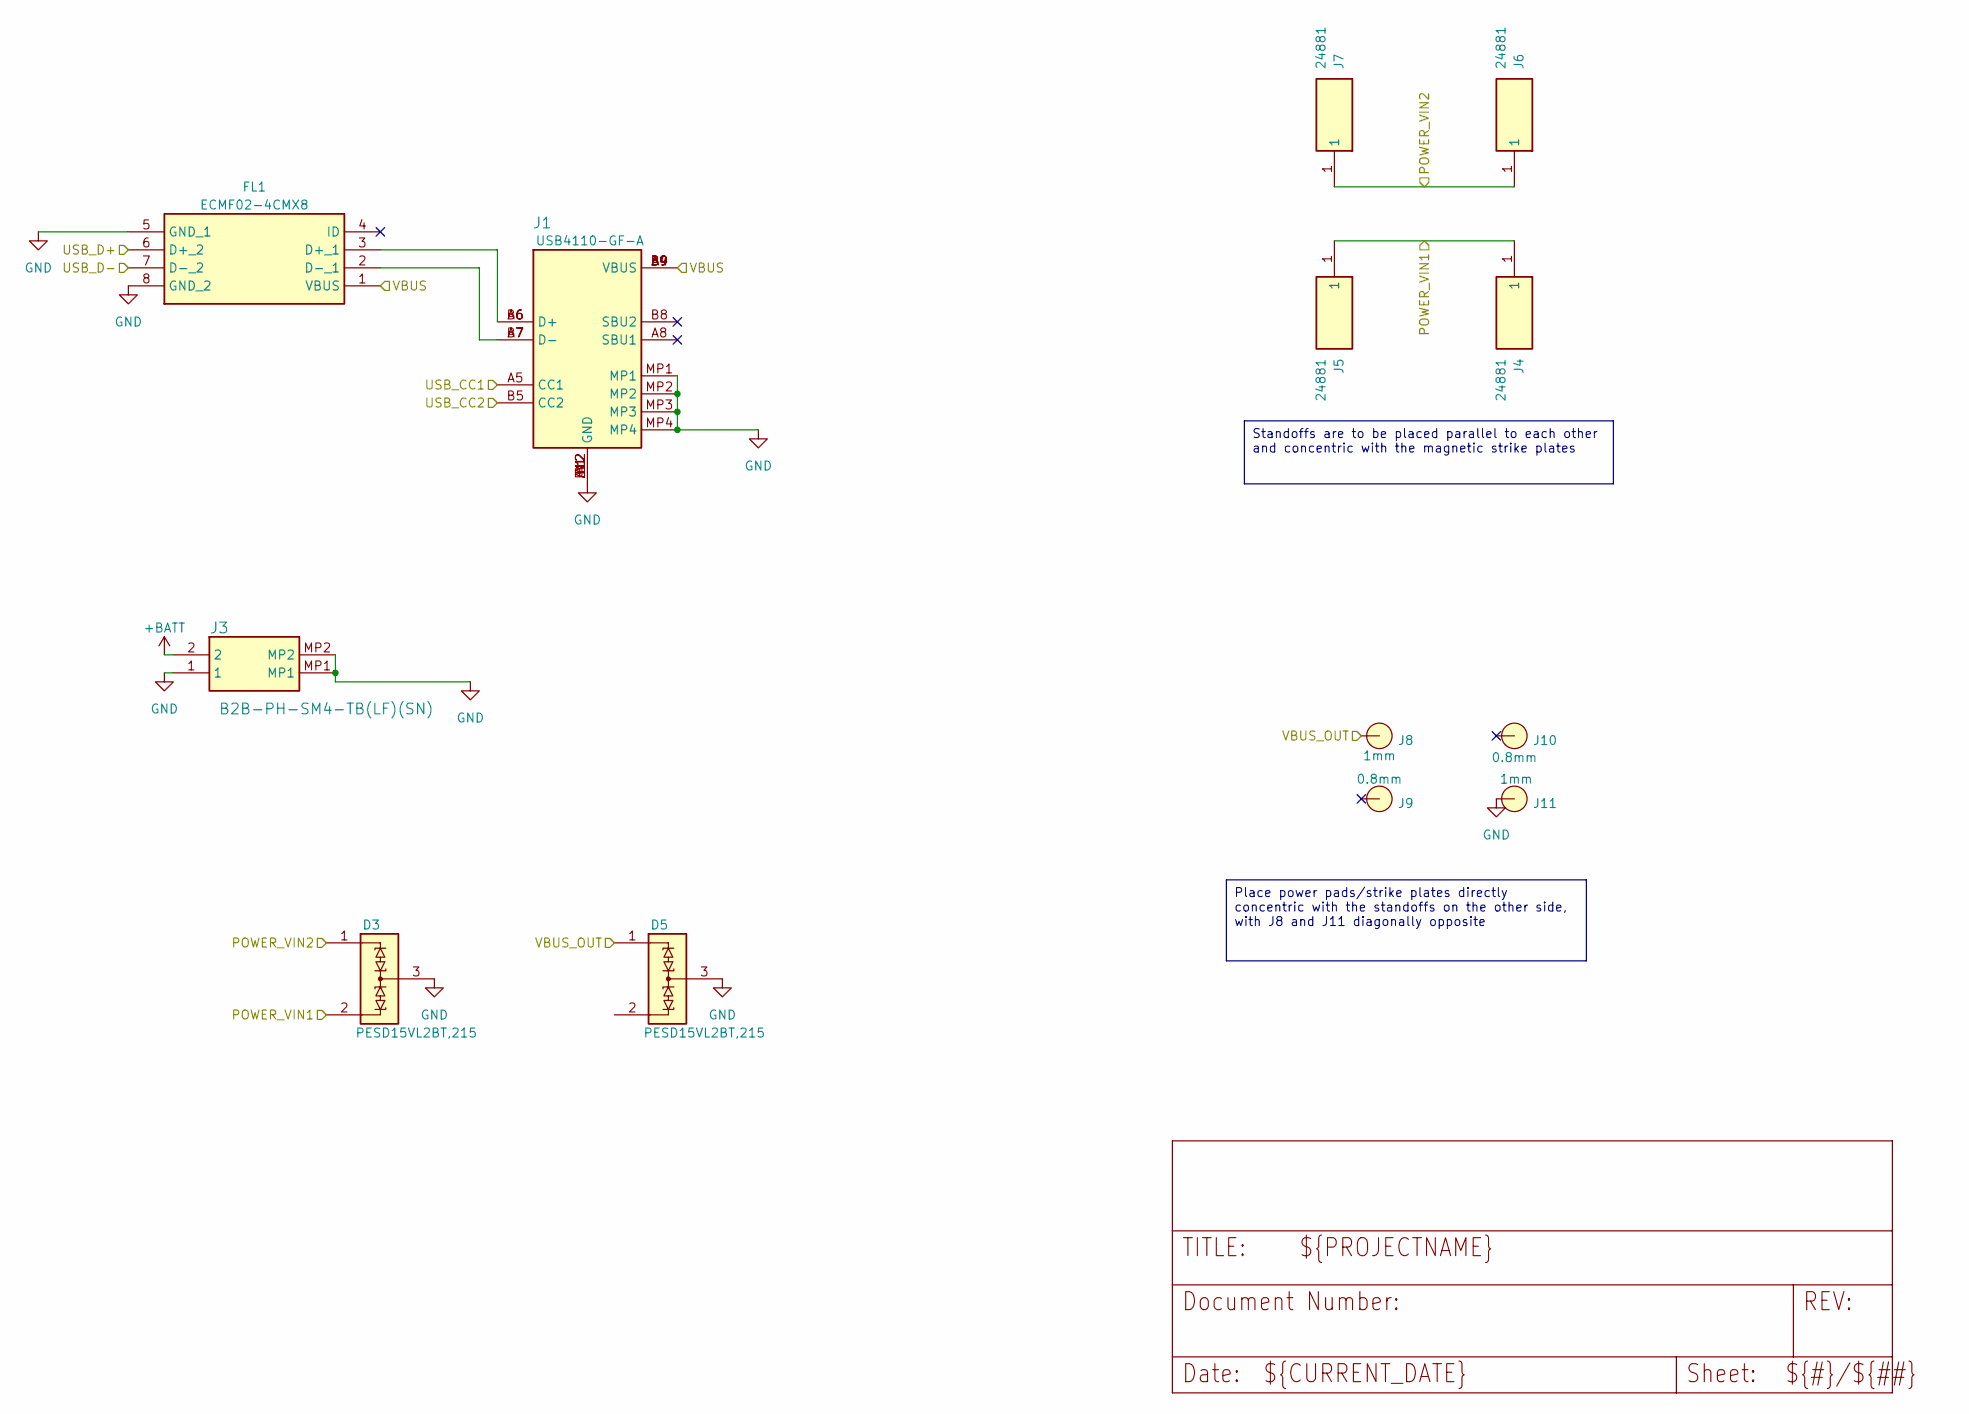
[picture p27: schematic Eros Tracker Connectors.kicad_sch]

Parts:
D3, D5: PESD15VL2BT,215; SOT95P230X110-3N; Mouser Part Number 771-PESD15VL2BT-T/R
FL1: ECMF02-4CMX8; ECMF024CMX8; Mouser Part Number 511-ECMF02-4CMX8
J1: USB4110-GF-A; USB4110GFA; Mouser Part Number 640-USB4110-GF-A
J3: B2B-PH-SM4-TB(LF)(SN); B2BPHSM4TBLFSN; Manufacturer_Part_Number B2B-PH-SM4-TB(LF)(SN); DigiKey Part Number 455-B2B-PH-SM4-TBCT-ND
J4, J5, J6, J7: 24881; 2488x-NPTH; Mouser Part Number 534-24881
J8, J11: 1mm; 10mmDisc
J9, J10: 0.8mm; 10mmDisc

Connections:
+BATT: J3.2; also elsewhere on the board
/Eros Tracker Connectors/POWER_VIN1: D3.2, J4.1, J5.1; also elsewhere on the board
/Eros Tracker Connectors/POWER_VIN2: D3.1, J6.1, J7.1; also elsewhere on the board
/Eros Tracker Connectors/USB_CC1: J1.A5 (CC1); also elsewhere on the board
/Eros Tracker Connectors/USB_CC2: J1.B5 (CC2); also elsewhere on the board
/Eros Tracker Connectors/USB_D+: FL1.6 (D+_2); also elsewhere on the board
/Eros Tracker Connectors/USB_D-: FL1.7 (D-_2); also elsewhere on the board
/Eros Tracker Connectors/VBUS: FL1.1 (VBUS), FL1.10, J1.A4 (VBUS), J1.A9 (VBUS), J1.B4 (VBUS), J1.B9 (VBUS); also elsewhere on the board
/Eros Tracker Connectors/VBUS_OUT: D5.1, J8.1; also elsewhere on the board
GND: D3.3, D5.3, FL1.5 (GND_1), FL1.8 (GND_2), FL1.9, FL1.12, J1.A1 (GND), J1.A12 (GND), J1.B1 (GND), J1.B12 (GND), J1.MP1, J1.MP2, J1.MP3, J1.MP4, J3.1, J3.MP1, J3.MP2, J11.1; also elsewhere on the board
unnamed: FL1.3 (D+_1), J1.A6 (D+), J1.B6 (D+)
unnamed: FL1.2 (D-_1), J1.A7 (D-), J1.B7 (D-)

Notes on the sheet:
Standoffs are to be placed parallel to each other and concentric with the magnetic strike plates
Place power pads/strike plates directly concentric with the standoffs on the other side, with J8 and J11 diagonally opposite
