SomaticVR/Eros-Hardware/Eros Tracker.kicad_pcb

## KiCad design Eros Tracker.kicad_pcb (continued)

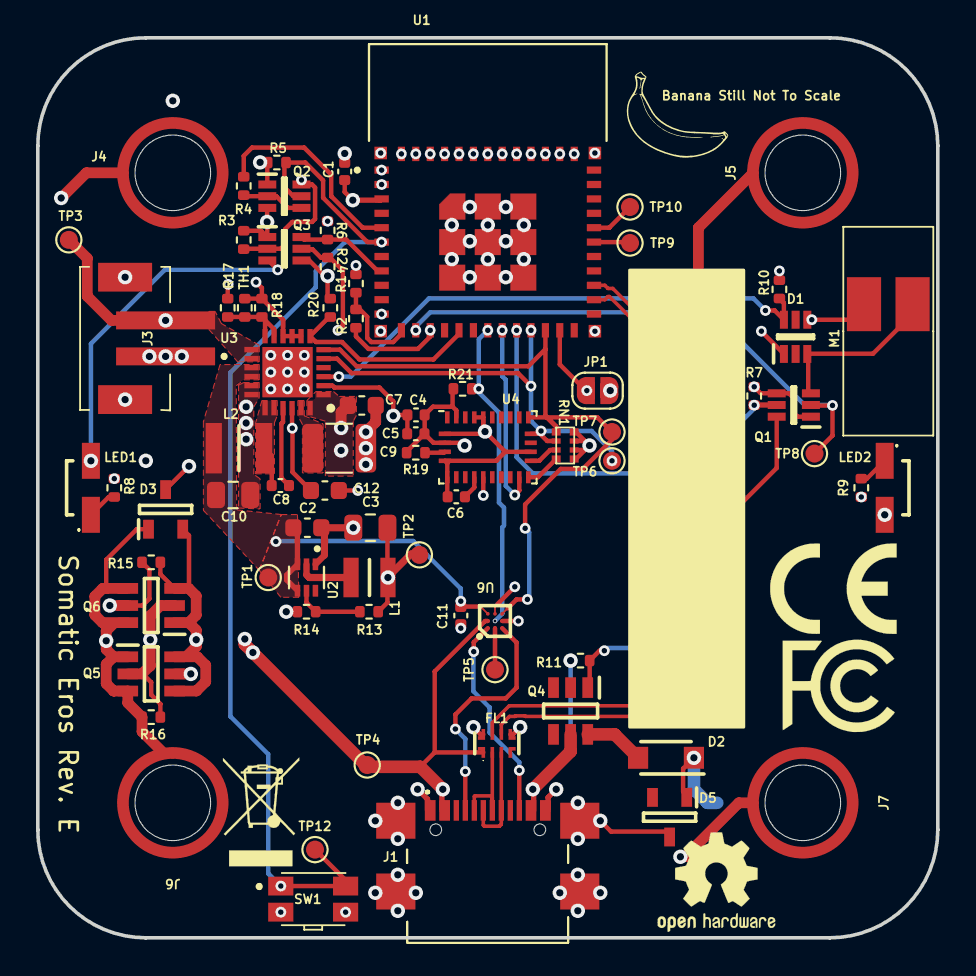
[picture p28: board Eros Tracker.kicad_pcb from above]

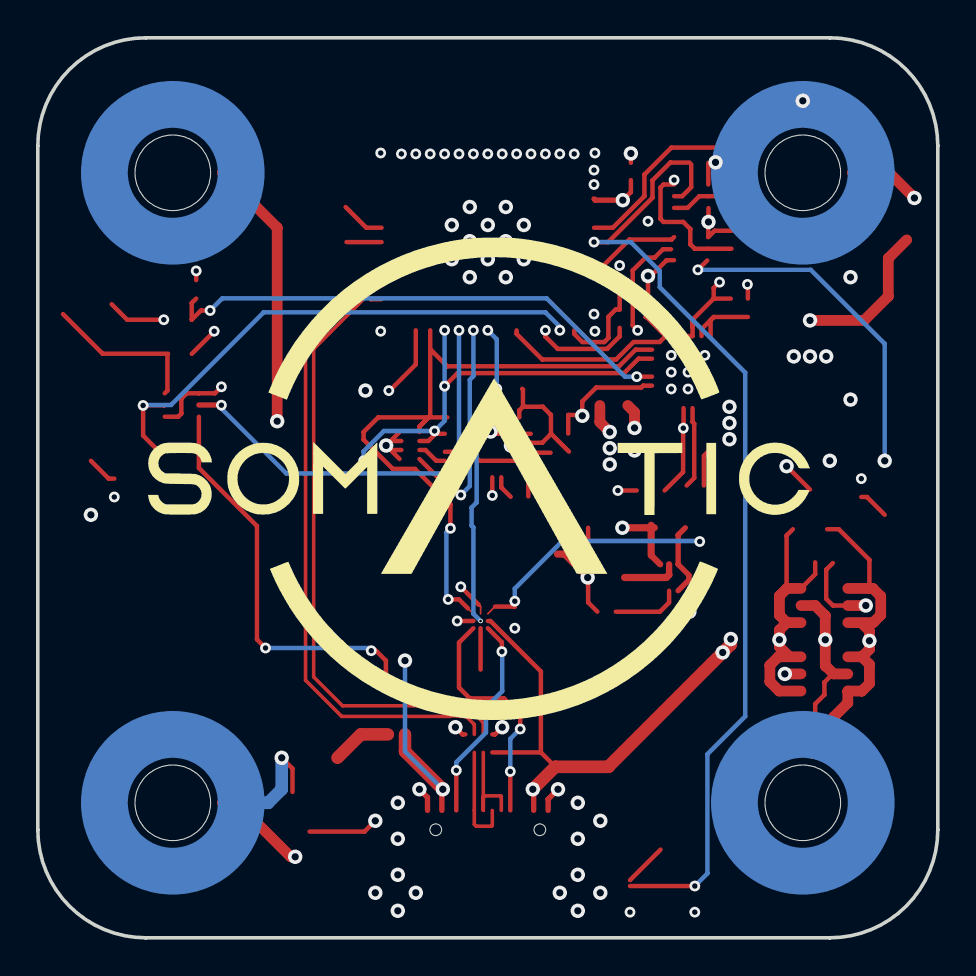
[picture p29: board Eros Tracker.kicad_pcb from below]

Board: 4 copper layers, 50.0 x 50.0 mm, 85 parts (5 on the bottom side), 49 nets.
