SomaticVR/Eros-Hardware/(commit log)

2023-06-04 Midway through board layout
    [2171790001.stp, APDA3020.STEP, DFE252012F-1R0M=P2.stp, DMP2240UDM-7.stp, ESP32-C3-WROOM-02-N4--3DModel-STEP-269445.STEP, EVQ-9P701P.stp, Eros Tracker BNO086 IMU.kicad_sch, Eros Tracker Connectors.kicad_sch]
2023-06-08 Alpha release
    [Eros Tracker Connectors.kicad_sch, Eros Tracker Power - Battery.kicad_sch, Eros Tracker.kicad_pcb, Strike Plate v1.step]
2023-07-19 Added cuts and jumps for Rev A
    [Eros Tracker BNO086 IMU.kicad_sch, Eros Tracker Connectors.kicad_sch, Eros Tracker Microcontroller.kicad_sch, Eros Tracker Power - Battery.kicad_sch, Eros Tracker.csv, Eros Tracker.kicad_sch]
2023-10-31 Rev B release + Panel. pcb and sch changes lost. panel shows updates.
    [4Z08V1345T7D2.stp, B2B-PH-SM4-TB_LF__SN_.stp, CAY10-xxxJ4.stp, ECMF02-4CMX8.stp, ESP32-C3-MINI-1-N4.step, EVQ-P7A01P.stp, PESD5V2S2UT,215.stp, S2B-PH-SM4-TB_LF__SN_ v1 with connector.step]
2023-10-31 RevC release. Power passthrough, battery voltage monitoring, IMU interrupt line fixed. TVS diodes added to all human-reachable connections.
    [Eros Tracker BNO086 IMU.kicad_sch, Eros Tracker Connectors.kicad_sch, Eros Tracker Microcontroller.kicad_sch, Eros Tracker Power - Battery.kicad_sch, Eros Tracker.csv, Eros Tracker.kicad_pcb, Eros Tracker.kicad_sch]
2023-10-31 Folder reorginization and .gitignore update
    [2171790001.stp, 4Z08V1345T7D2.stp, APDA3020.STEP, B2B-PH-SM4-TB_LF__SN_.stp, CAY10-xxxJ4.stp, DFE252012F-1R0M=P2.stp, DMP2240UDM-7.stp, ECMF02-4CMX8.stp]
2024-04-02 Rev D realease
    [BAS40VYX.stp, Eros Tracker Connectors.kicad_sch, Eros Tracker Microcontroller.kicad_sch, Eros Tracker Power - Battery.kicad_sch, Eros Tracker.csv, Eros Tracker.kicad_pcb, Eros Tracker.kicad_sch, TLV61070ADBVR.stp]
2025-02-08 Rev E release
    [AP62250Z6-7.stp, BQ24074RGTRG4.stp, BQ24196RGER.stp, BQ25185DLHR.stp, DFE322512F-2R2M=P2.stp, Eros Tracker BNO086 IMU.kicad_sch, Eros Tracker Connectors.kicad_sch, Eros Tracker Microcontroller.kicad_sch]
