SomaticVR/Eros-Hardware/(notices)

Notices in the files:
Testing/Cube.py:
it under the terms of the GNU General Public License as published by
